Preimtime/Project_CRT/README.md

# Projektarbeit_CRT
Work by Alexander Preimesberger and Frank Ebel.
