Preimtime/Project_CRT/presentation/presentation.tex

%%%%%%%%%%%%%%%%%%%%%%%%%%%%%%%%%%%%%%%%%
% Beamer Presentation
% LaTeX Template
% Version 1.0 (10/11/12)
%
% This template has been downloaded from:
% http://www.LaTeXTemplates.com
%
% License:
% CC BY-NC-SA 3.0 (http://creativecommons.org/licenses/by-nc-sa/3.0/)
%
%%%%%%%%%%%%%%%%%%%%%%%%%%%%%%%%%%%%%%%%%

%----------------------------------------------------------------------------------------
%	PACKAGES AND THEMES
%----------------------------------------------------------------------------------------

\documentclass[aspectratio=169]{beamer}

\mode<presentation> {

% The Beamer class comes with a number of default slide themes
% which change the colors and layouts of slides. Below this is a list
% of all the themes, uncomment each in turn to see what they look like.

%\usetheme{default}
%\usetheme{AnnArbor}
%\usetheme{Antibes}
%\usetheme{Bergen}
%\usetheme{Berkeley}
%\usetheme{Berlin}
%\usetheme{Boadilla}
%\usetheme{CambridgeUS}
%\usetheme{Copenhagen}
%\usetheme{Darmstadt}
%\usetheme{Dresden}
%\usetheme{Frankfurt}
%\usetheme{Goettingen}
%\usetheme{Hannover}
%\usetheme{Ilmenau}
%\usetheme{JuanLesPins}
%\usetheme{Luebeck}
\usetheme{Madrid}
%\usetheme{Malmoe}
%\usetheme{Marburg}
%\usetheme{Montpellier}
%\usetheme{PaloAlto}
%\usetheme{Pittsburgh}
%\usetheme{Rochester}
%\usetheme{Singapore}
%\usetheme{Szeged}
%\usetheme{Warsaw}

% As well as themes, the Beamer class has a number of color themes
% for any slide theme. Uncomment each of these in turn to see how it
% changes the colors of your current slide theme.

%\usecolortheme{albatross}
%\usecolortheme{beaver}
%\usecolortheme{beetle}
%\usecolortheme{crane}
%\usecolortheme{dolphin}
%\usecolortheme{dove}
%\usecolortheme{fly}
%\usecolortheme{lily}
%\usecolortheme{orchid}
%\usecolortheme{rose}
%\usecolortheme{seagull}
%\usecolortheme{seahorse}
%\usecolortheme{whale}
%\usecolortheme{wolverine}

%\setbeamertemplate{footline} % To remove the footer line in all slides uncomment this line
%\setbeamertemplate{footline}[page number] % To replace the footer line in all slides with a simple slide count uncomment this line

%\setbeamertemplate{navigation symbols}{} % To remove the navigation symbols from the bottom of all slides uncomment this line
}

\usepackage{graphicx} % Allows including images
\usepackage{booktabs} % Allows the use of \toprule, \midrule and \bottomrule in tables

\usepackage{siunitx}
\usepackage{caption}
\usepackage{subcaption}

%----------------------------------------------------------------------------------------
%	TITLE PAGE
%----------------------------------------------------------------------------------------

\title[CRT]{Preliminary research on an electron beam setup for the QUAK experiment} % The short title appears at the bottom of every slide, the full title is only on the title page

\author{Frank Ebel\\ Alexander Preimesberger} % Your name
\institute[TU] % Your institution as it will appear on the bottom of every slide, may be shorthand to save space
{
TU Wien \\ % Your institution for the title page
\medskip
01429282\\ 01427641
}
\date{15. March 2021} % Date, can be changed to a custom date

\begin{document}

\begin{frame}
\titlepage % Print the title page as the first slide
\end{frame}

\begin{frame}
\frametitle{Overview} % Table of contents slide, comment this block out to remove it
\tableofcontents % Throughout your presentation, if you choose to use \section{} and \subsection{} commands, these will automatically be printed on this slide as an overview of your presentation
\end{frame}

%----------------------------------------------------------------------------------------
%	PRESENTATION SLIDES
%----------------------------------------------------------------------------------------

%------------------------------------------------
\section{CRT} % Sections can be created in order to organize your presentation into discrete blocks, all sections and subsections are automatically printed in the table of contents as an overview of the talk
%------------------------------------------------

\subsection{Characterization} % A subsection can be created just before a set of slides with a common theme to further break down your presentation into chunks

\begin{frame}
	\frametitle{Characterization}
	\begin{itemize}
		\item Model Heerlen D14-363GY/123
		\item Voltage \SI{2}{\kilo\volt}
		\item Filament heating voltage \SI{\approx 6}{\volt}
		\item Metal oxide cathode with barium-, strontium-, and possibly aluminum-oxide
	\end{itemize}
\end{frame}

%------------------------------------------------

\begin{frame}
	\frametitle{CRT}
	\begin{figure}
		\centering
		\begin{subfigure}{.4\textwidth}
			\centering
			
		\end{subfigure}%
		\begin{subfigure}{.4\textwidth}
			\centering
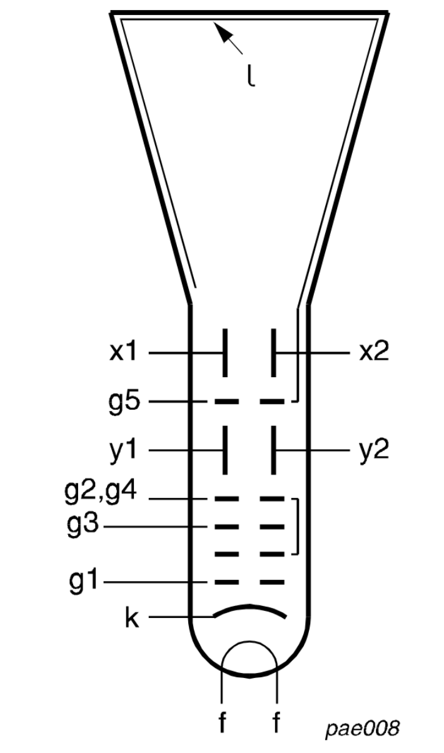
[picture p1: Chapters/CRT-Basics/electrode configuration.png]
			
		\end{subfigure}
	\end{figure}
\end{frame}

%------------------------------------------------

\begin{frame}
	\frametitle{Cathode SEM image}
	\begin{figure}
		\centering
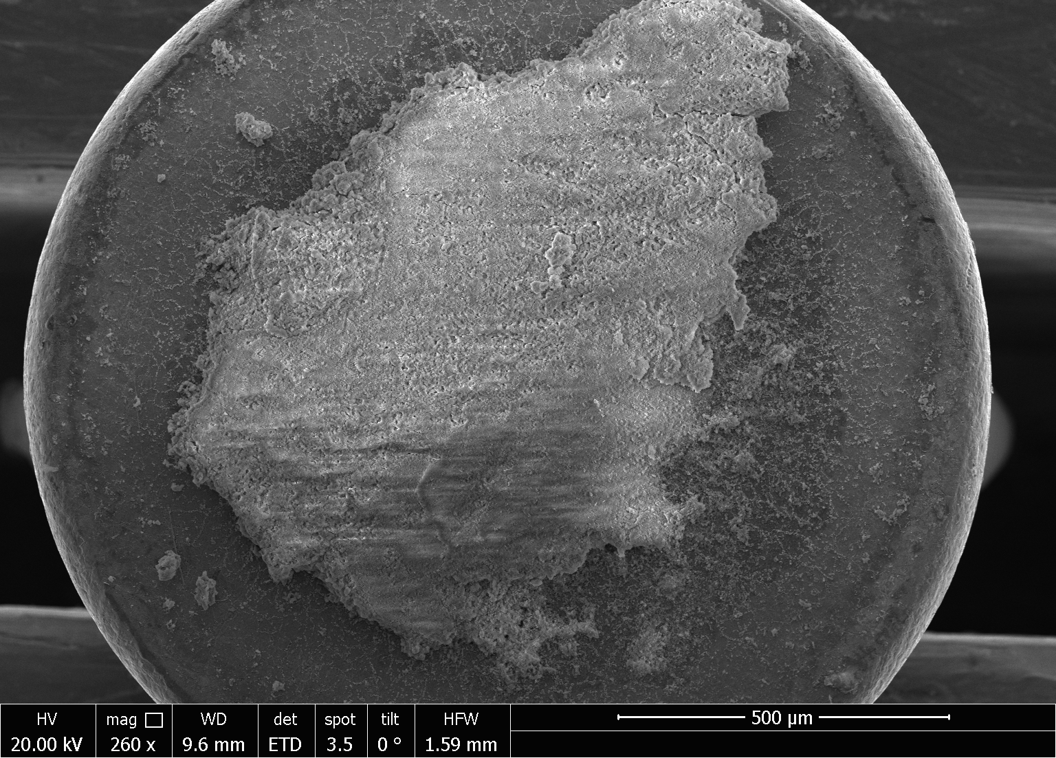
[picture p2: Chapters/CRT-Basics/SEM_image.png]
		
	\end{figure}
\end{frame}

%------------------------------------------------

\begin{frame}
	\frametitle{Heater}
	\begin{figure}[ht]
		\centering
		 \\
		\vspace{0.5cm}
		
	\end{figure}
\end{frame}

%------------------------------------------------
\subsection{Cutting}

\begin{frame}
	\frametitle{Wire cutting}
	\begin{figure}[ht]
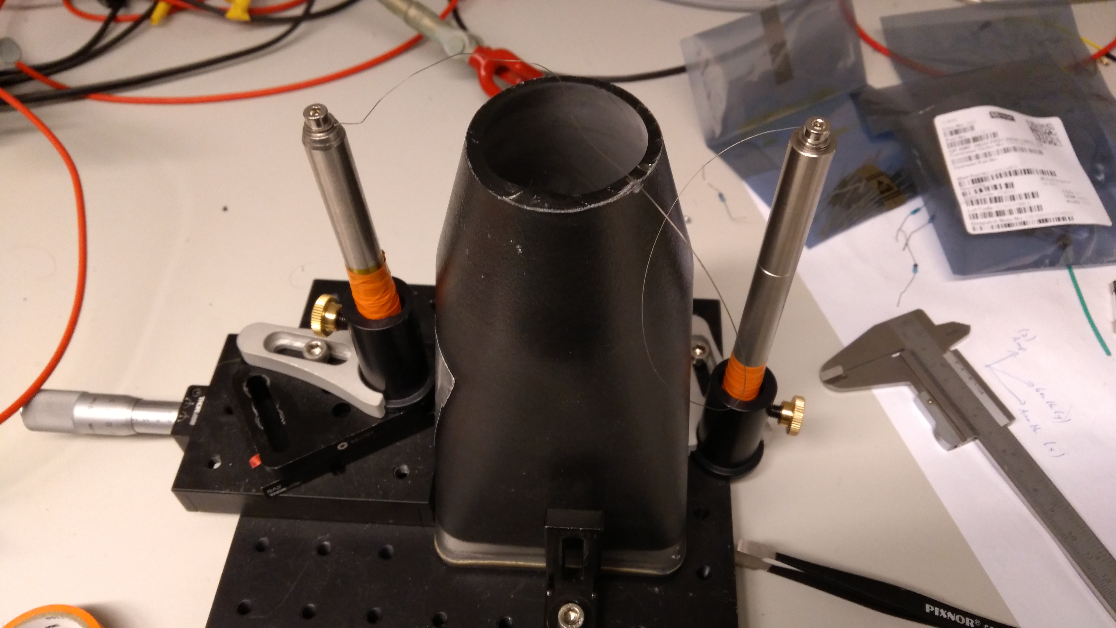
[picture p3: Chapters/CRT-handling/Cutting_Stage.jpg]
		
	\end{figure}
\end{frame}

%------------------------------------------------
\section{Vacuum test chamber}

\begin{frame}
	\frametitle{3D rendering}
	\begin{figure}[ht]
		\centering
		
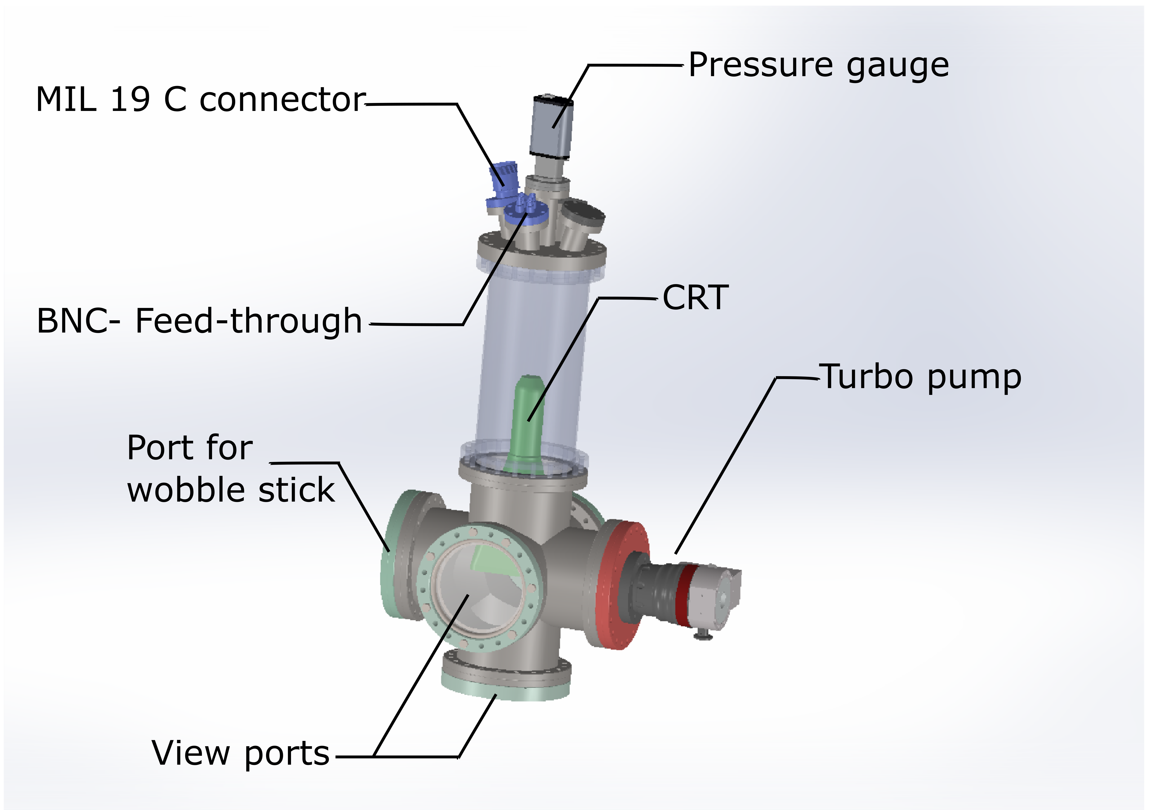
[picture p4: Chapters/vacuum-chamber/vacuum-chamber-annotated.png]
		 % taken from OneNote QuaK/Vacuum Setup/Test vacuum chamber
	\end{figure}
\end{frame}

%------------------------------------------------
\section{Deflection Electronics}

\begin{frame}
	\frametitle{Deflection Electronics}
	\begin{figure}[ht]
		\centering
		
	\end{figure}
\end{frame}

%------------------------------------------------

\begin{frame}
	\frametitle{Deflection circuit diagram}
	\begin{figure}[ht]
		\centering
		
	\end{figure}
\end{frame}

%------------------------------------------------

\begin{frame}
	\frametitle{Measurements of center tapped transformer}
	\begin{figure}[ht]
		\centering
		\begin{subfigure}{0.4\textwidth}
			\centering
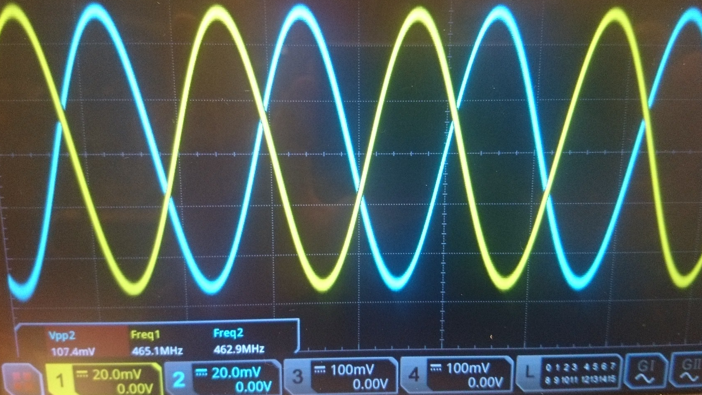
[picture p5: Chapters/Deflection/unbiased3.png]
			
			\caption{Unbiased at \SI{465}{\mega\hertz}}
		\end{subfigure}
		\hspace{0.1\textwidth}
		\begin{subfigure}{0.4\textwidth}
			\centering
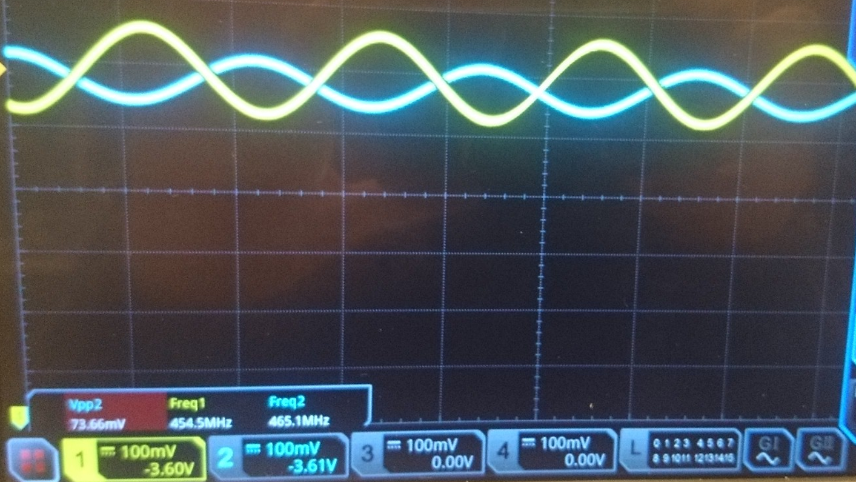
[picture p6: Chapters/Deflection/biased3.png]
			
			\caption{Biased at \SI{465}{\mega\hertz}}
		\end{subfigure}
	\end{figure}
\end{frame}

%------------------------------------------------
\section{Beam characterization}

\begin{frame}
	\frametitle{First measurements of e-beam}
	\begin{figure}[h]
		\centering
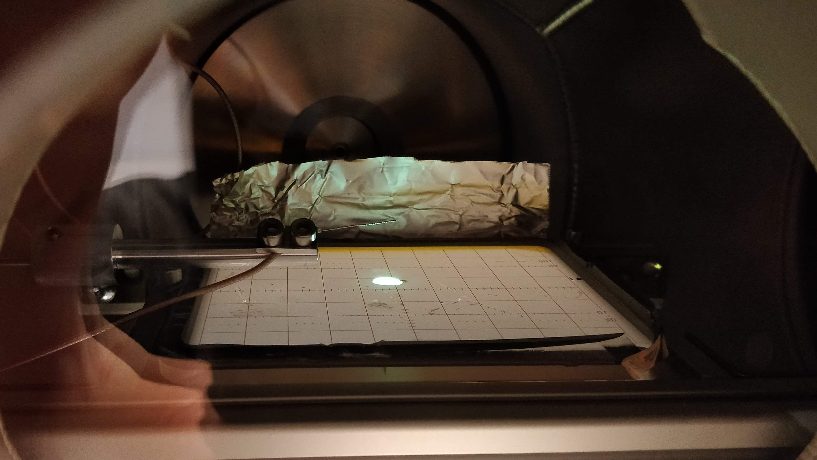
[picture p7: Chapters/beam-characterization/center_image.jpg]
		
	\end{figure}
\end{frame}

%------------------------------------------------

\begin{frame}
	\frametitle{Measured beam current (aluminum)}
	\begin{figure}[h]
		\centering
		
	\end{figure}
\end{frame}

%------------------------------------------------

\begin{frame}
	\frametitle{Schematics Faraday cup}
	\begin{figure}[h]
		\centering
		
	\end{figure}
\end{frame}

%------------------------------------------------

\begin{frame}
	\frametitle{Measured beam current (cup)}
	\begin{figure}[h]
		\centering
		
	\end{figure}
\end{frame}
%------------------------------------------------

\begin{frame}
	\frametitle{Measurement of deflection frequency}
	\begin{figure}
		\centering
		
	\end{figure}
\end{frame}

%------------------------------------------------

\begin{frame}
\Huge{\centerline{Thank you for your attention!}}
\end{frame}

%----------------------------------------------------------------------------------------

\end{document}
