Preimtime/Project_CRT/Preamble/titlepage_alternative.tex

% !TeX encoding = UTF-8
% !TeX spellcheck = en_US
% !TeX root = ../Thesis.tex
\renewcommand{\maketitle}{
	\begingroup % Create the command for including the title page in the document
		\thispagestyle{empty}
		\newgeometry{bottom=3cm, top=3cm, left=2.5cm+\bindingOffset, right=2.5cm}
		\begin{center}
			\begin{figure}[h]
				\centering
				
			\end{figure}

			\vspace{\stretch{0.1}}
			\begin{LARGE}	
				\par\noindent%
%				{\Large DIPLOMARBEIT}\\
				{\large Project Report}\\
				\vspace{\stretch{0.1}}
				\textbf{\huge \title} \\
				\ifBOOL@subtitle
					\subtitle
				\fi
			\end{LARGE}
			
			\vspace{\stretch{0.3}}
				performed at \institute \\
				\ifBOOL@instituteLogo
					\begin{figure}[h]
						\centering
						
					\end{figure}
				\fi
				at \university\\
				Faculty of Physics
				
				\vspace{\stretch{0.3}}
				under the supervision of\\
				\textbf{\large \supervisor} \\
				\ifBOOL@advisors
					and \\
					\textbf{\large \advisors} \\
				\fi

				\vspace{\stretch{0.1}}
				by \\
				\vspace{\stretch{0.1}}
				\textbf{\Large \author} \\
				\vspace{\stretch{0.05}}
				Matrikelnummer: \authorMatriculationNumber \\
				\vspace{\stretch{0.02}}
				\authorAdress
				\vspace{\stretch{0.1}}
		\end{center}
		
		\ifsigned
			\authorSign \\
			\vspace{\stretch{0.3}} \\
			\supervisorSign
		\fi
		
		\ifplace
			\placeSign
		\fi
		\restoregeometry
	\endgroup	
}
