Preimtime/Project_CRT/Chapters/CRT-handling/CRT-handling.tex

% !TeX encoding = UTF-8
% !TeX spellcheck = en_US
% !TeX root = ../../Thesis.tex

\chapter{CRT handling}
\label{chap:CRT handling}

\section{Opening CRTs}
\label{sec:Opening CRTs}

In order to have a free electron beam in the experimental setup to  manipulate the internal states of cold potassium atoms in a coherent way, it is necessary to open the CRT. This section explains the different methods which were tried and which resulted in clean and easy cuts. All slices were made in a glove box filled with nitrogen gas (\cref{fig:glovebox}) to reduce oxygen poisoning of the cathode.

\begin{figure}[ht]
	\centering
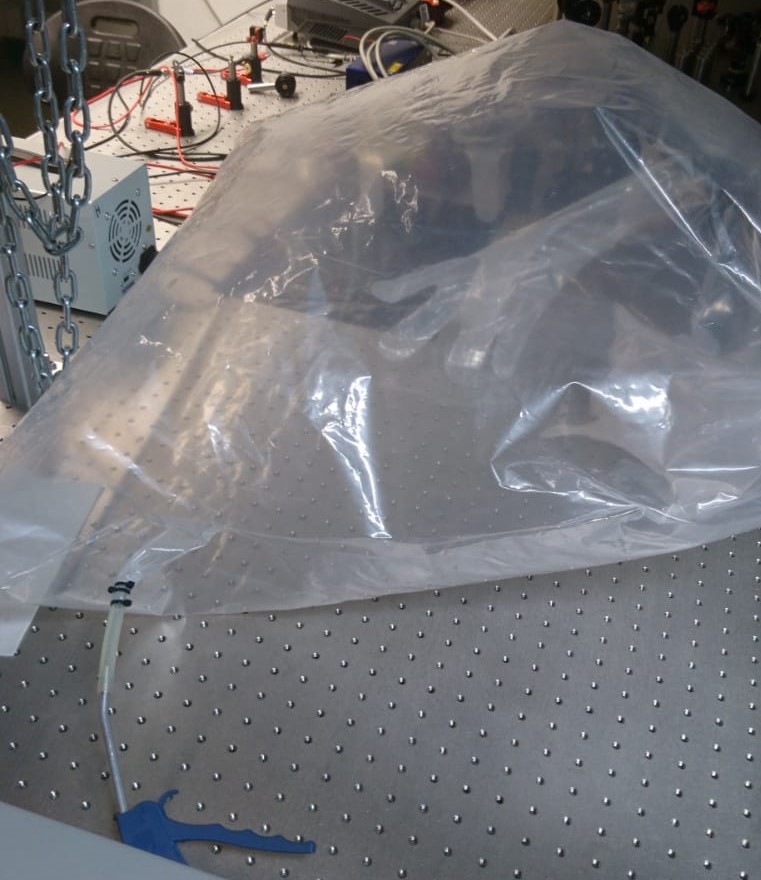
[picture p13: Chapters/CRT-handling/glove_box.jpg]
	
	\caption{Glovebox filled with nitrogen gas to open CRTs.}
	\label{fig:glovebox}
\end{figure}

\subsection{Rotary tool}
\label{subsec:Rotary tool}

First, a small hole was drilled in the center of the CRT pins to pressurize the CRT with nitrogen. Then a diamond wheel attached to a rotary tool was used to cut the glass. This method was tried twice, but did not work well. A lot of glass dust was produced, which adhered to the electron optics. Additionally, the dust got stuck to the inside of the plastic box and obscured the view of the blade while cutting.

\subsection{Wire cutting}
\label{subsec:Wire cutting}

Higher success was achieved by cutting the glass with a heated wire. A small hole was cut into the glove box in which two wires were put through. The hole was sealed with hot glue. A small height adjustable stage was built out of optic element mounts (\cref{fig:Stage to cut CRT with wire}) in which the CRT was put with the phosphor screen facing down. A steel wire (made from a mixture of Fe 70/Cr 25/Al 5) with a diameter of \SI{0.25}{\milli\meter} was looped around the CRT. It is important to keep a small gap in the loop to avoid an electrical short. Therefore two notches were made into the CRT glass in which the wire was fixed.

The assembly was put inside the glove box, which was subsequently filled with nitrogen. A current of approximately \SIrange{2}{2.5}{\ampere} was used to heat the thin wire which resulted in a clean fracture inside the CRT glass. This method does not require a CRT pressurization before the cut and was first extensively tested on empty drinking glasses.

\begin{figure}[ht]

	
	%\missingfigure[figwidth=0.9\textwidth]{Image of Stage.}
	\caption{Stage to cut CRT with wire.}
	\label{fig:Stage to cut CRT with wire}
\end{figure}

\section{Oxygen poisoning}
\label{sec:Oxygen poisoning}

As mentioned in \cref{ch:Cathodic Ray Tube Basics} it is paramount to avoid contact of the cathode with oxygen. Therefore tests with a broken CRT were made to test on how well it can be isolated from air.

% daily notes 2019-12-11
The first experiment consisted of filling a drinking glass put upside-down with helium. After a set amount of time a a burning lighter was put inside. If the fire went off, it meat that oxygen did not get inside. This was tested successfully with a waiting time of \SIrange{0.5}{10}{\minute}.

Next, plastic wrap was put on top of the glass filled with nitrogen by a rubber band. The glass was put with the open side up from \SIrange{3}{10}{\minute} after which it was turned upside down and the foil was removed. A lighter was put inside and the flame went out again.

To improve the precision, a He leak tester was used. For the first two tests, one plastic foil and one rubber band were used; for the third test three foils and two rubber bands; and for the last test an aluminum foil was hot glued on the CRT to seal it. The measurement locations are shown in \cref{fig:Measurement locatiosn of He leakage}. For the glued seal, leakage was measured on the whole circumference. In \cref{tab:He leak test series.} `glue avg' denotes the average leak rate of this measurement while `glue max' describes the highest value. A seal with rubber band and clear foil tend to higher leakage. Based on these measurements it is recommended to use glued aluminum. But care needs to be taken in order ensure that the whole CRT is sealed since even a small leak can result in a rate around an order of magnitude above the background.

\begin{table}[ht]
	\centering
	\caption{He leak test.}
	\label{tab:He leak test series.}
	
	\begin{tabular}{l S}
		\toprule
		
		location & {leak rate/(\SI{e-5}{\milli\bar.\litre/\second})} \\
		\midrule
		
		% 1st video
		\multicolumn{2}{c}{1 plastic foil, 1 rubber band} \\
		background & 8 \\
		plastic foil & 20 \\
		He gas cylinder & 200 \\
		\midrule
		
		% 2nd video
		\multicolumn{2}{c}{1 plastic foil, 1 rubber band} \\
		background & 7 \\
		plastic foil & 20 \\
		rubber band & 40 \\
		\midrule
		
		% 3rd video
		\multicolumn{2}{c}{3 foils, 2 rubber bands} \\
		background & 20 \\
		plastic foil & 30 \\
		rubber band & 70 \\
		\midrule
		
		% 4th video
		\multicolumn{2}{c}{1 aluminum foil, hot glue} \\
		background & 6 \\
		glue avg & 7 \\
		glue max & 60 \\
		aluminum foil & 8 \\
		\bottomrule
	\end{tabular}
\end{table}

\begin{figure}[ht]
	\centering
	
	\begin{subfigure}[b]{0.4\textwidth}
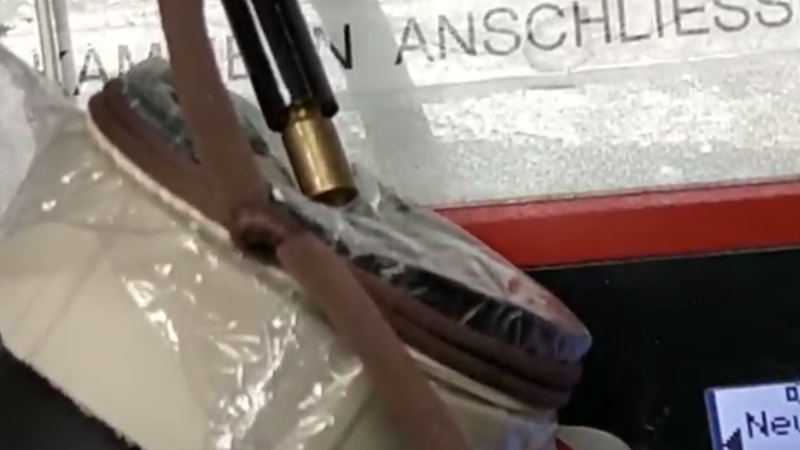
[picture p14: Chapters/CRT-handling/plastic_foil.png]
		
		\caption{plastic foil}
	\end{subfigure}
	\hspace{0.1\textwidth}
	\begin{subfigure}[b]{0.4\textwidth}
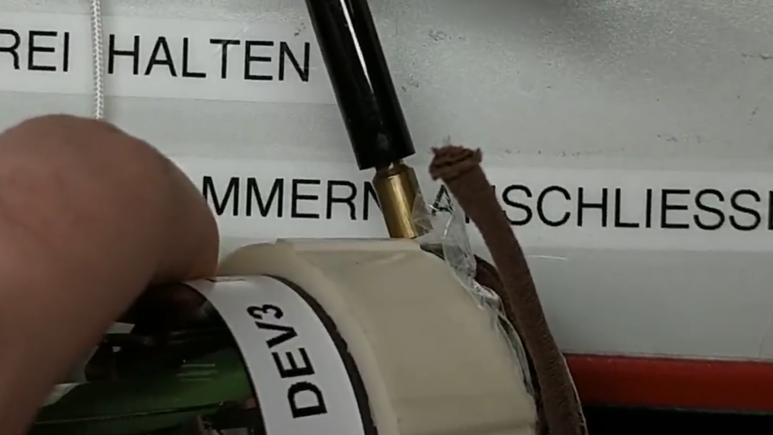
[picture p15: Chapters/CRT-handling/rubber_band.png]
		
		\caption{rubber band}
	\end{subfigure}

	\vspace{1cm}
	
	\begin{subfigure}[b]{0.4\textwidth}
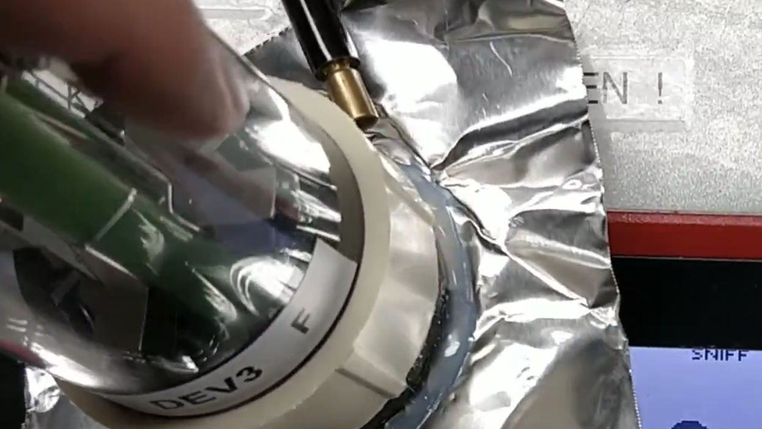
[picture p16: Chapters/CRT-handling/glue.png]
		
		\caption{glue}
	\end{subfigure}
	\hspace{0.1\textwidth}
	\begin{subfigure}[b]{0.4\textwidth}
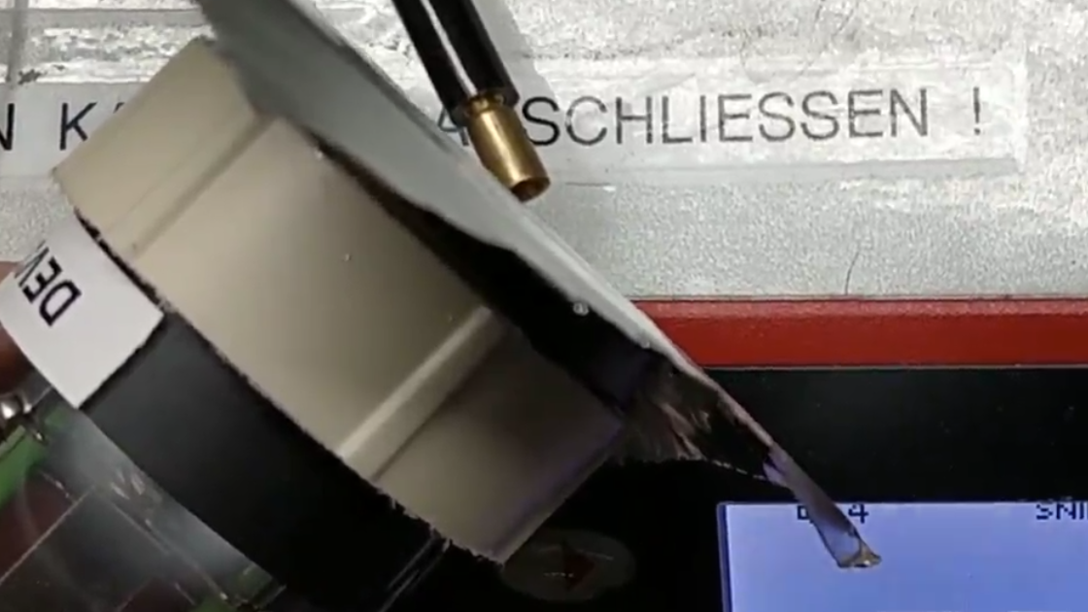
[picture p17: Chapters/CRT-handling/aluminum_foil.png]
		
		\caption{aluminum}
	\end{subfigure}
	
	\caption{Measurement locations of He leakage.}
	\label{fig:Measurement locatiosn of He leakage}
\end{figure}
