Preimtime/Project_CRT/Chapters/Deflection/Deflection.tex

% !TeX encoding = UTF-8
% !TeX spellcheck = en_US
% !TeX root = ../../Thesis.tex

\chapter{Deflection Electronics}

\section{Demands on the setup}

For the QUAK experiment it is paramount to be able to deflect a beam of a sufficient current precisely at the right frequency with a sufficiently small bandwidth. 
As previously mentioned, our deflection system simply consists of two pairs of parallel plates between which an alternating voltage is applied. Controlling this voltage allows us to control the deflection of the beam. Various aspects are important here (illustrated in \cref{fig:VoltageAspects}):

\begin{description}
	
	\item[Offset:] Although the deflection of the beam is controlled by the voltage between the plates, it is necessary to be able to set their mean potential as well. During normal operation this offset voltage is at \SI{96}{\volt} for the x-direction and at \SI{78}{\volt} for the y-direction. These offsets are necessary to keep the beam focused.
	\item[Amplitude:] The deflection coefficients in the x and y planes are \SI{19}{\volt\per\centi\meter} and \SI{11.5}{\volt\per\centi\meter} respectively (see \cite{D14363GY123-manual}). We therefore need to be able to supply up to \SI{100}{\volt} in order to be able to move the beam in a large enough area.
	\item[Frequency:] The final goal is to be able to deflect the electron beam at the hyperfine splitting frequency of $^{39}\mathrm{K}$, which is \SI{461.7}{\mega\hertz} or $^{41}\mathrm{K}$, with a frequency of \SI{254}{\mega\hertz}. This is likely to prove impossible with this CRT-model, observations at the highest frequency we have tried so far will be discussed in section \cref{sec:Deflection frequency}.
	\item[Waveform:] Ultimately we want the cold atoms to experience a field that oscillates like a sine wave. As a first try it is therefore reasonable to apply a sinusoidal voltage.
	\item[Lissajous curves:] Having the ability to control the deflection in both the x- and the y- axis, allows us to have our beam draw out Lissajous Curves (\cref{fig:Lissajous Curves}). By applying sine waves of equal frequency to both pairs of deflection plates and by being able to control the phase between them we can have the beam oscillate on a straight line or a circle. This allows us to generate either a linearly or circularly polarized field.
\end{description}

\begin{figure}[ht]
	\centering
		
	\caption{Charactaristics of the generated deflection voltages.}
	\label{fig:VoltageAspects}
\end{figure}

\begin{figure}[ht]
	\centering
	
	\begin{tikzpicture}
		\input{./Chapters/Deflection/fig_Lissajous}
	\end{tikzpicture}
	
	\caption{Lissajous Curves.}
	\label{fig:Lissajous Curves}
\end{figure}

\section{Implementation}

\begin{figure}[ht]
	\centering
	
	\begin{tikzpicture}
		\input{./Chapters/Deflection/fig_deflection_electonics}
	\end{tikzpicture}
	\caption{Deflection circuit.}
	\label{fig:deflec_circuit}
\end{figure}

\begin{figure}[ht]
	\centering
	\begin{subfigure}{0.4\textwidth}
		\centering
		
		\caption{}
		%\label{fig:circuit_phase}
	\end{subfigure}
	\hspace{0.1\textwidth}
	\begin{subfigure}{0.4\textwidth}
		\centering
		
		\caption{}
		%\label{fig:PCB_phase}
	\end{subfigure}
	\caption{Images of deflection plates.}
	\label{fig:deflection plates}
\end{figure}

A first setup with which we can try to obtain the desired voltages is depicted in \cref{fig:deflec_circuit}. On the  very left we have a signal generator that is capable of producing the right frequency (\SI{461.7}{\mega\hertz}) this signal is then split up into an x-, and a y-branch. One of the two branches is connected to a phase shifter, which is able to delay the input signal by up to \SI{200}{\degree}, allowing us to set any desired phase shift between x-, and y-deflection and to correct for inadvertent delays from the other electronics. Both the x-, and  y-signal are then amplified using Mini Circuits ZHL amplifiers. In the final step, a center tapped transformer allows us to produce voltages for the plates X1 and X2 (or Y1 and Y2 respectively) with a phase shift of exactly \SI{180}{\degree} between them. By setting the center tap to the desired offset potential, we should get the voltage curves described above. To understand this setup in more detail, it is useful to examine its most important parts more closely:

\begin{description}
	\item[Amplifier:] Up to now we have used the Mini Circuits ZHL 32A \cite{MiniCircuits2021a}  and the ZHL 1A \cite{MiniCircuits2021} amplifier, which have a fixed gain of \SIlist{25; 16}{\decibel} respectively. Inputs and outputs can simply be connected via BNC cables. The amplifier is powered by a linear power supply with a DC voltage of \SI{24}{\volt} via two banana plugs in the front. Since we want to control the Lissajous curves shapes (as the deflection coefficients for the x- and y- plates differ), it is desirable to be able to adjust the amplifier gain in future versions of the setup. 
	
	\item[Center Tapped Transformer:] The center tapped transformer we use is the Mini-Circuits TC8-1G2+ (\cite{TC8-1G2}), a transformer for frequencies between \SIrange{2}{500}{\mega\hertz}, with an impedance ratio of 8. \Cref{fig:CTT} shows how the center tapped transformer is implemented. The in- and outputs, as well as the bias voltage can be connected via BNC cables. As usual, the shields of all these cables are connected to ground, furthermore they are connected to each other and to the housing. As a safety feature, both outputs X1 and X2 are directly connected to the bias through an arrangement of diodes: Two connections, each with a normal diode and a Zener diode facing in opposite directions. The breakthrough voltage of the Zener diode is \SI{200}{\volt}, during normal operation the voltage on it stays below this value and none of the connections let any current through as one of the two diodes is always blocking it. However if one of the plates in the CRT accidentally comes in contact with high voltage, the connection with the appropriately oriented Zener diode opens up, preventing a voltage spike on the center tapped transformer and thereby protecting the electronics connected to its primary circuit.
	At the point of writing there are still some problems with the behavior of the center tapped transformer, the capacitance of the diodes introduces an undesired phase shift between the two signals. \Cref{fig:unbiased2} shows the circuit's behavior at \SI{465}{\mega\hertz} without its diodes, here the signals are shifted by $\SI{120}{\pico\second} \mathrel{\widehat{=}} \SI{20}{\degree} = \SI{0.35}{\radian}$. Additionally, applying a bias voltage leads to differing amplitudes, as can be seen in \cref{fig:biased2}.
	
	\item[Phase Shifter:] To control the phase shift between the x- and y-deflection plates, we use a Mini-Circuits \cite{JSPHS-661} phase shifter. This part was put in a  housing (\cite{Hammond1455D601RD}) on a separate PCB and can be connected via BNC cables. \Cref{fig:circuit_phase} shows how the phase shifter is connected and \cref{fig:PCB_phase} shows the corresponding PCB layout. Note that again the shields of the BNC cables are connected among each other and to the housing. The JSPHS-661+ is designed for frequencies in the range \SIrange{400}{600}{\mega\hertz}. By applying a DC voltage of \SIrange{0}{12}{\volt} to the bias connector, it is possible to introduce a phase shift of up to \SI{200}{\degree} to the signal.
	
\end{description}

\begin{figure}[ht]
	\centering
	\begin{subfigure}{0.4\textwidth}
		\centering
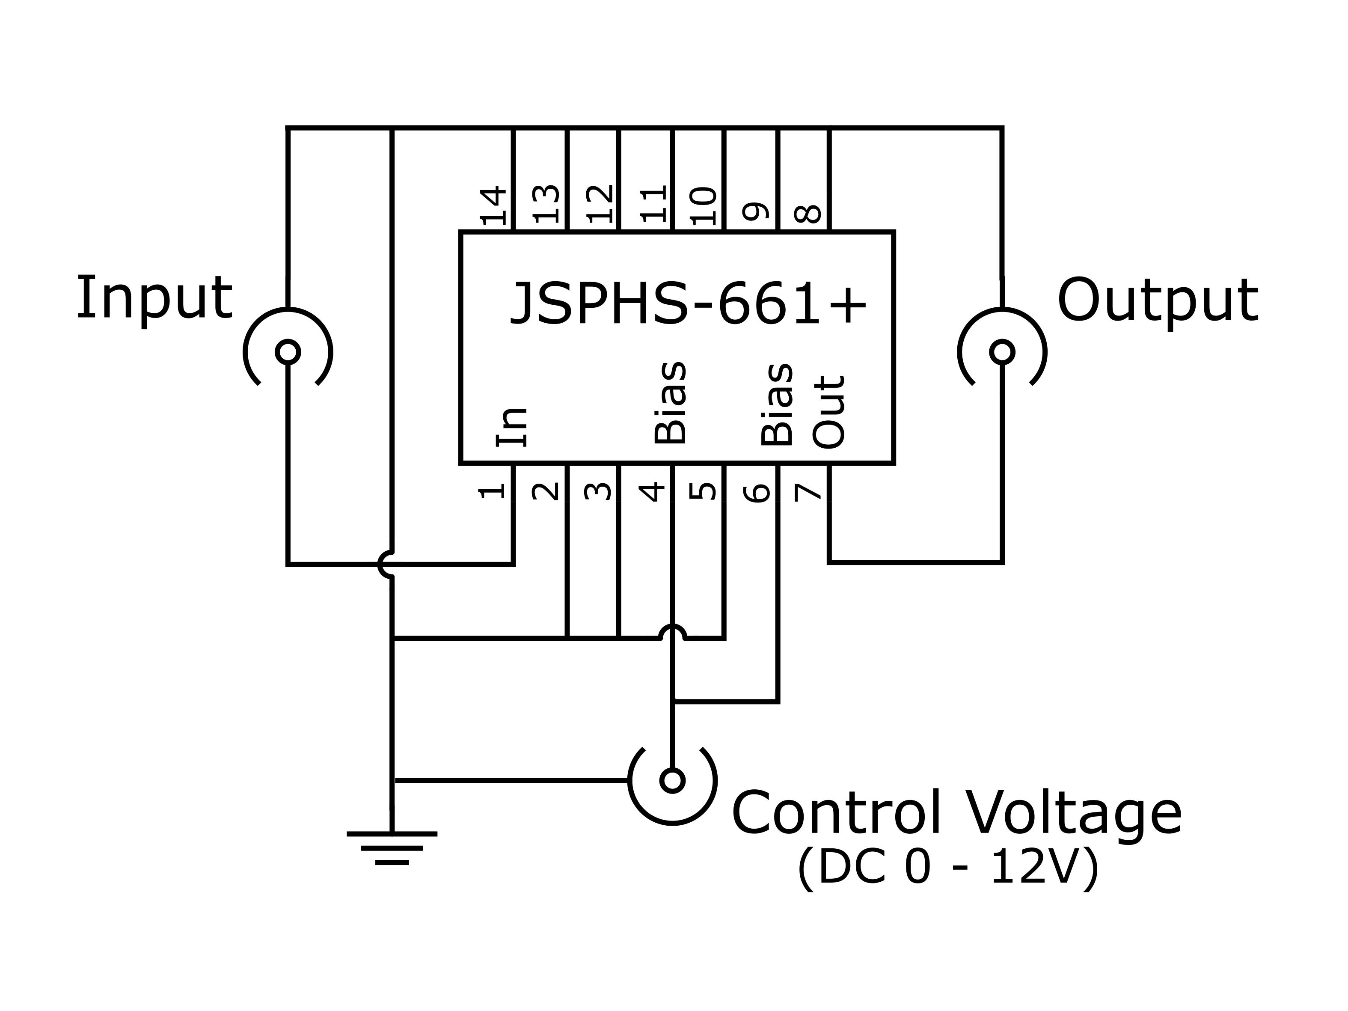
[picture p18: Chapters/Deflection/circuit_phase4zu3.png]
		
		\caption{Schematic of phase shifter connections.}
		\label{fig:circuit_phase}
	\end{subfigure}
	\hspace{0.1\textwidth}
	\begin{subfigure}{0.4\textwidth}
		\centering
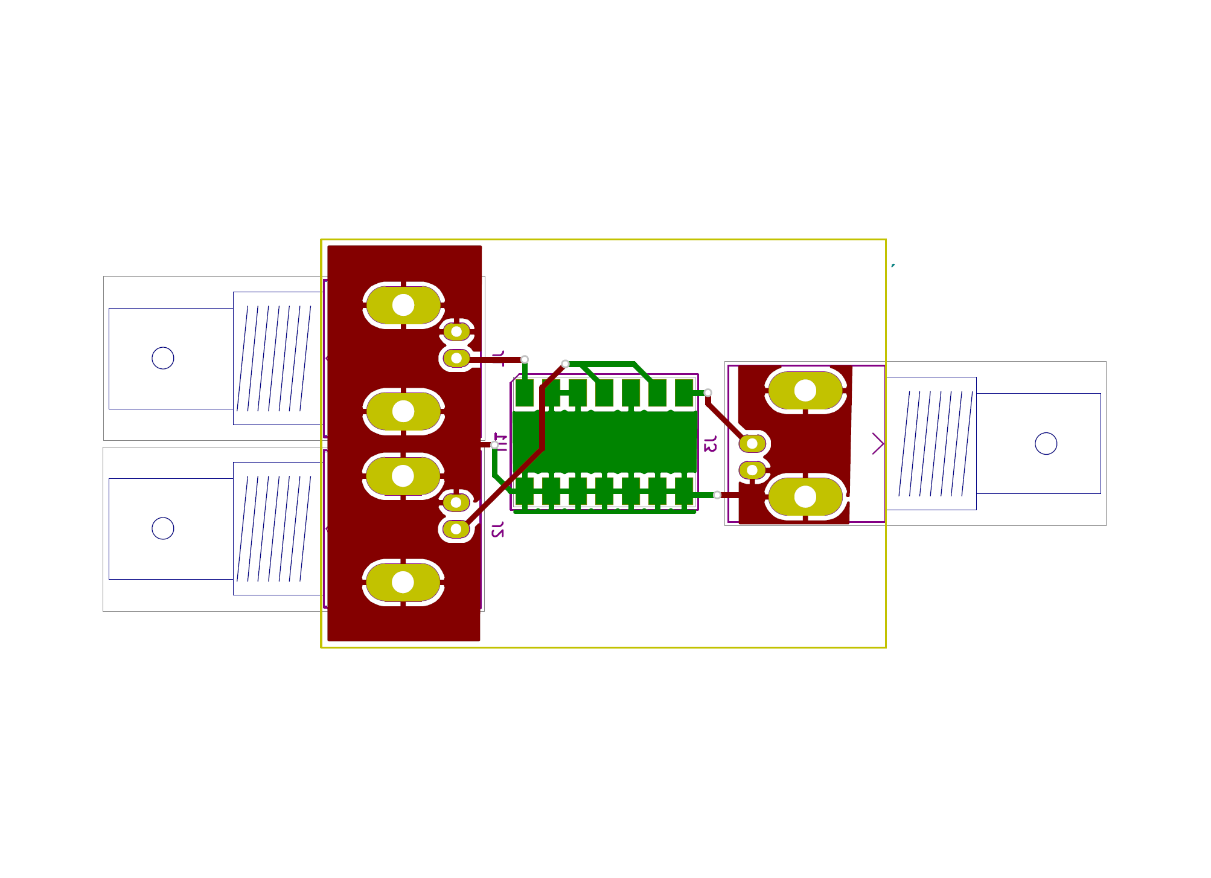
[picture p19: Chapters/Deflection/PCB_phase3.png]
		
		\caption{PCB-Layout of the phase shifter.}
		\label{fig:PCB_phase}
	\end{subfigure}
	\caption{}
	\label{fig:PhaseShifter}
\end{figure}

\begin{figure}[ht]
	\centering
	\begin{subfigure}{0.4\textwidth}
		\centering
		
		\caption{Signal of center tapped transformer without diodes, unbiased at \SI{465}{\mega\hertz}.(\SI{1}{\nano\second}/division horizontally and \SI{20}{\milli\volt}/division vertically) }
		\label{fig:unbiased2}
	\end{subfigure}
	\hspace{0.1\textwidth}
	\begin{subfigure}{0.4\textwidth}
		\centering
		
		\caption{Signal of center tapped transformer without diodes, biased at \SI{465}{\mega\hertz}.(\SI{1}{\nano\second}/division horizontally, \SI{100}{\milli\volt}/division vertically, \SI{-3.6}{\volt} offset)}
		\label{fig:biased2}
	\end{subfigure}
	\caption{}
	\label{fig:CTTSignal}
\end{figure}

\begin{figure}[ht]
	\centering
	\begin{subfigure}{0.4\textwidth}
		\centering
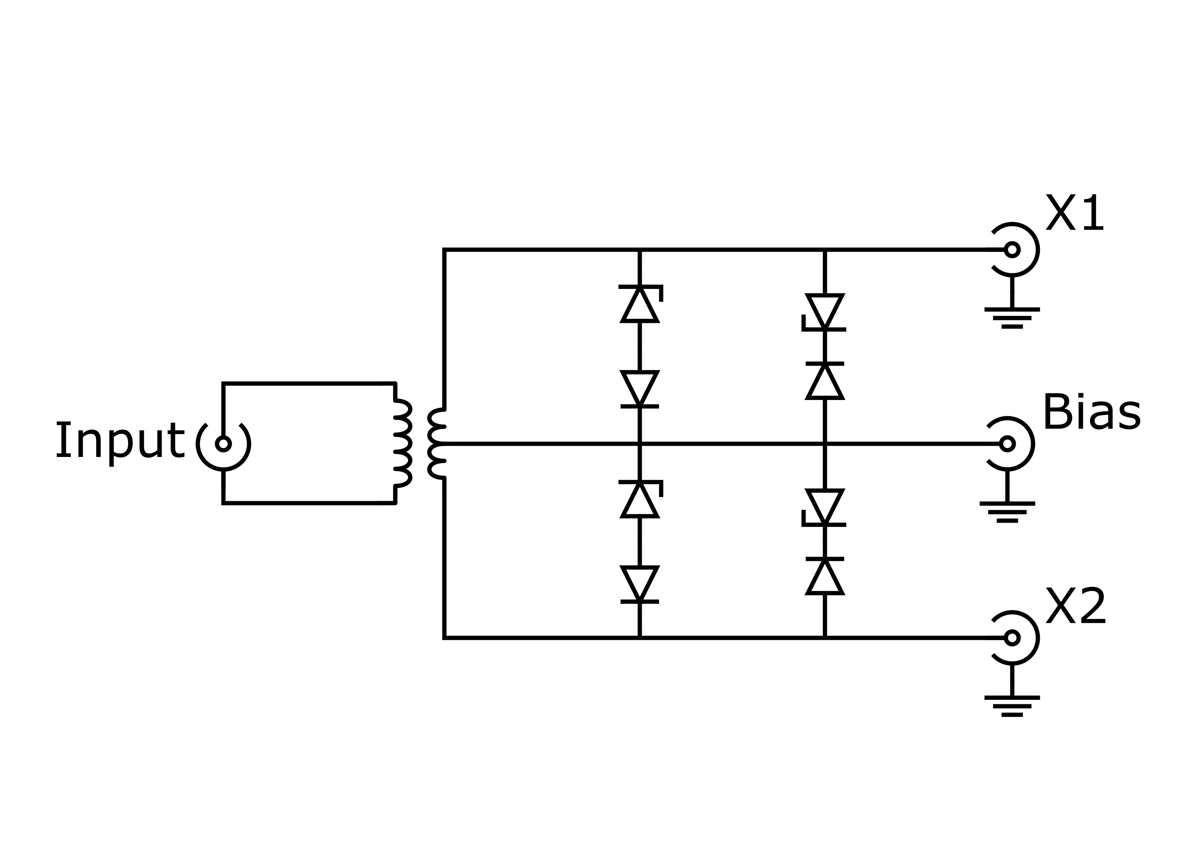
[picture p20: Chapters/Deflection/circuit_CTT4zu3.png]
		
		\caption{Schematic of center tapped transformer connections.}
		\label{fig:circuit_ctt}
	\end{subfigure}
	\hspace{0.1\textwidth}
	\begin{subfigure}{0.4\textwidth}
		\centering
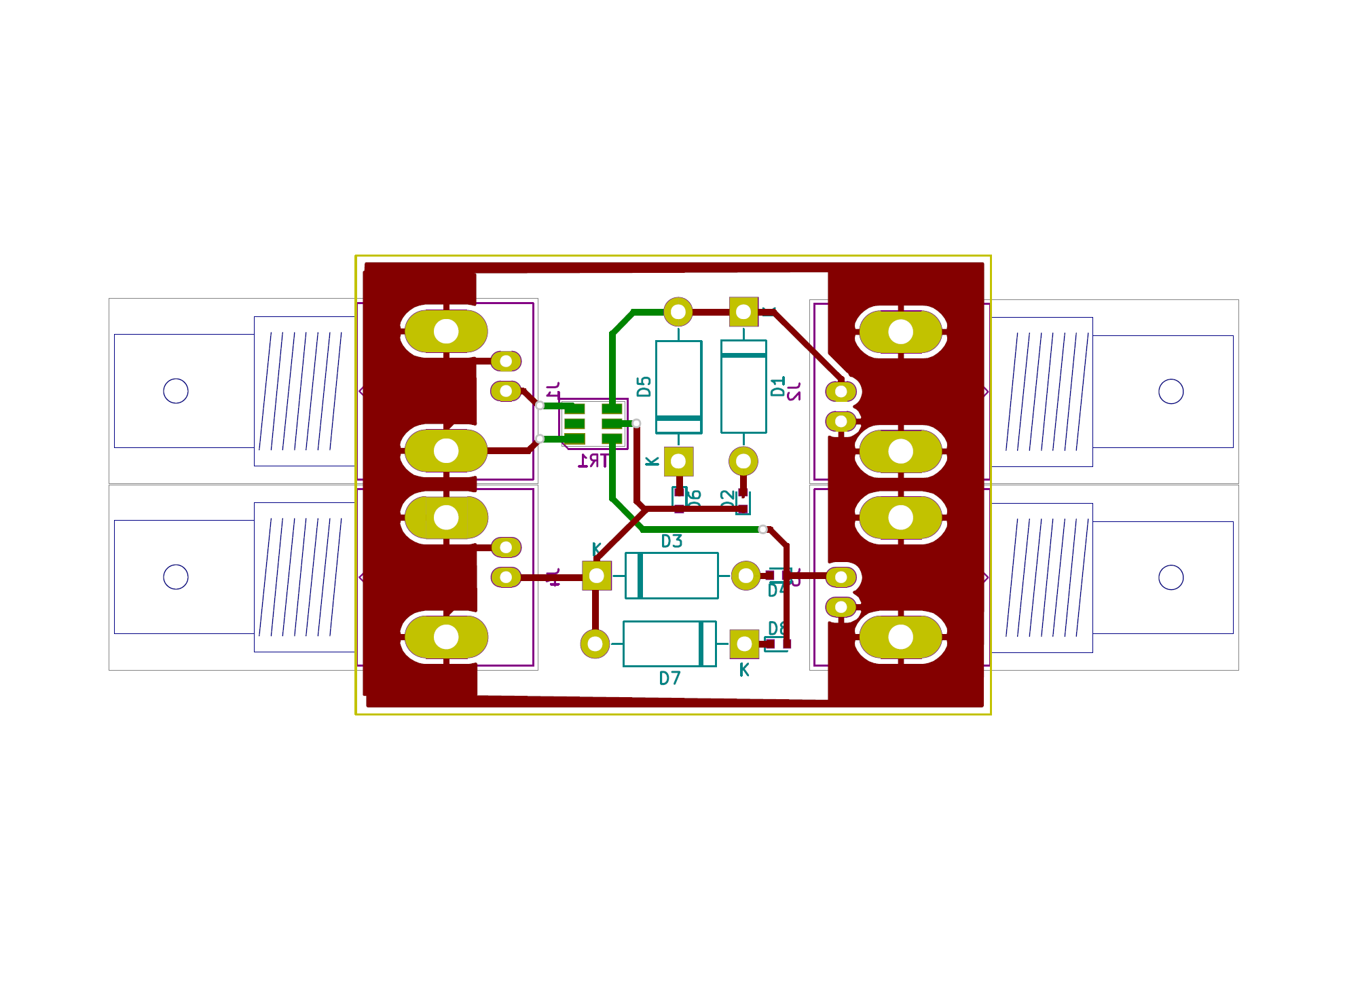
[picture p21: Chapters/Deflection/PCB_CTT3.png]
		
		\caption{PCB-Layout for center tapped transformer.}
		\label{fig:PCB_CTT}
	\end{subfigure}
	\caption{}
	\label{fig:CTT}
\end{figure}

\begin{figure}[ht]
	\centering
	\begin{subfigure}{0.4\textwidth}
		\centering
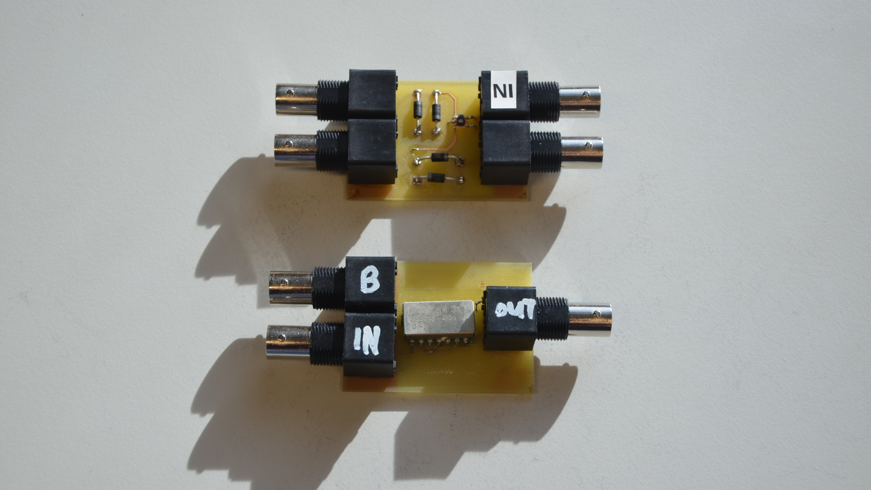
[picture p22: Chapters/Deflection/PS_CTT_16zu9.JPG]
		
		\caption{Finished PCBs.}
		\label{fig:ctt_ps}
	\end{subfigure}
	\hspace{0.1\textwidth}
	\begin{subfigure}{0.4\textwidth}
		\centering
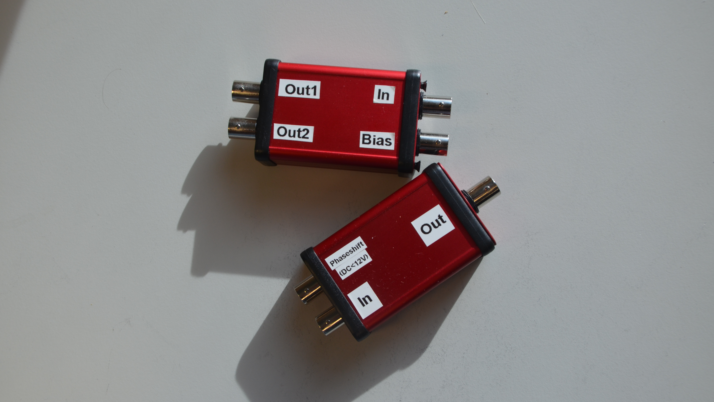
[picture p23: Chapters/Deflection/PS_CTT1_16zu9.JPG]
		
		\caption{Finished PCB in housing.}
		\label{fig:ctt_ps_housed}
	\end{subfigure}
	\caption{}
	\label{fig:CTT_housed}
\end{figure}
