Preimtime/Project_CRT/Chapters/Chapter3/chapter_3.tex

% !TeX encoding = UTF-8
% !TeX spellcheck = en_US
% !TeX root = ../../Thesis.tex
\chapter{Chapter 3}\label{chap:chapter_3}
This chapter contains a few Tikz sketches and diagrams as a inspiration and guide line to create your own Tikz figures.

\begin{figure}[H]
	\centering
	\resizebox{\textwidth}{!}{
		\begin{tikzpicture}[use optics, scale=1.0]
			\input{./Chapters/Chapter3/fig_DFS_scheme}
		\end{tikzpicture}
	}
	\caption[DFS setup]{optical setup for a \person{Doppler} free spectroscopy}
	\label{fig:dfs}
\end{figure}

\begin{figure}[H]
	\centering
	\begin{tikzpicture}[use optics, scale=0.7]
		\input{./Chapters/Chapter3/fig_reflective_imaging_sketch}
	\end{tikzpicture}
	\caption[optics sketch 1]{optics sketch 1}
	\label{fig:reflective_imaging_setup}
\end{figure}

\begin{figure}[H]
	\centering
	\begin{tikzpicture}[use optics, scale=0.7]
		\input{./Chapters/Chapter3/fig_trapping_with_wires}
	\end{tikzpicture}
	\caption[trapping atoms wiht a wire]{Trapping atoms with wires.}
	\label{fig:trapping_atoms_with_a_wire}
\end{figure}

%\clearpage
\begin{figure}[H]
	\centering	
	\begin{tikzpicture}[scale=0.55]
		\input{./Chapters/Chapter3/fig_Rb_hyperfine_structure}
	\end{tikzpicture}
	\caption[\Rb D1,D2 line]{\Rb hyperfine structure of the D1 and D2 line}
	\label{fig:Rb_hyperfine_structure}
\end{figure}

\begin{figure}[H]
	\centering
	\begin{tikzpicture}[scale=0.48]
		\input{./Chapters/Chapter3/fig_cryostat_overview}
	\end{tikzpicture}
	\caption[overview of cryogenic setup]{Overview sketch of the cryogenic setup}
	\label{fig:cryogenic_overview}
\end{figure}

\begin{figure}[H]
	\noindent
	\centering
	\begin{subfigure}[t]{0.49\textwidth}
		\centering
		\begin{tikzpicture}[use optics, scale=1.0]
		\input{./Chapters/Chapter3/fig_ECDL}
		\end{tikzpicture}
		\subcaption{}
		\label{fig:laser_types_ecdl}
	\end{subfigure}
	\begin{subfigure}[t]{0.49\textwidth}
		\centering
		\begin{tikzpicture}[use optics, scale=0.7]
		\input{./Chapters/Chapter3/fig_DFB_laser}
		\end{tikzpicture}
		\subcaption{}
		\label{fig:laser_types_dfb}
	\end{subfigure}
	\caption[laser types]{semiconductor laser types: (\subref{fig:laser_types_ecdl}) ECDL; (\subref{fig:laser_types_dfb}) DFB.}
	\label{fig:laser_types}
\end{figure}
