Preimtime/Project_CRT/Thesis.pdf

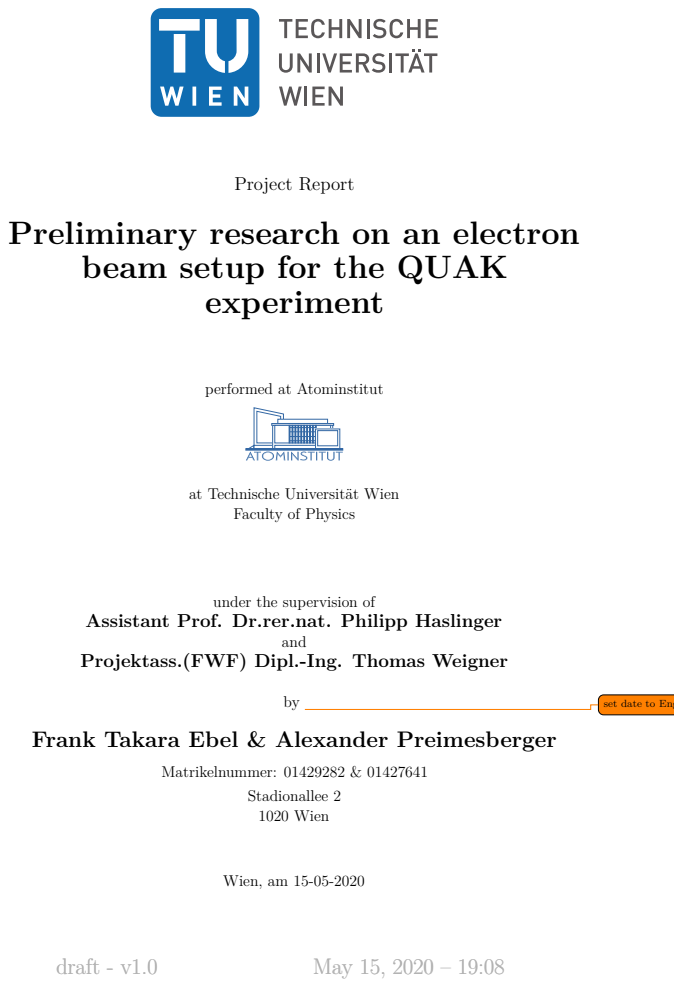
[picture p24: page 1]
draft - v1.0; May 15, 2020 – 19:08; Project Report; experiment; and; set date to English; Matrikelnummer: 01429282 & 01427641; Stadionallee 2 1020 Wien; Wien, am 15-05-2020

Preliminary research on an electron
beam setup for the QUAK

performed at Atominstitut

at Technische Universität Wien

Faculty of Physics

under the supervision of

Assistant Prof. Dr.rer.nat. Philipp Haslinger

Projektass.(FWF) Dipl.-Ing. Thomas Weigner

Frank Takara Ebel & Alexander Preimesberger

# Contents

1 Cathodic Ray Tube Basics | 1
Todo list | 9

i

# 1 Cathodic Ray Tube Basics

This section features a quick explanation what a CRT is and what its main components are, followed by a more detailed description on how these components are implemented in the CRT Heerlen D14-363GY, which was used in this project. It ends with a description of the important characteristics of the CRT and the requirement the theory poses on them.

## 1.1 Underlying Physics

Wikipedia states: “The cathode-ray tube (CRT) is a vacuum tube that contains one or more electron guns and a phosphorescent screen and is used to display images. It modulates, accelerates, and deflects electron beam(s) onto the screen to create the images.”

There are three vital components to accomplish this feat: the electron gun, the electron lens and the deflection plates.

The electron gun extracts electrons from a cathode material, accelerates them onto
a perforated anode and thereby produces a free electron beam (see fig. 1.1). One important characteristic in the selection of a cathode material is a low work function. 16 It denotes the amount of energy needed to extract one electron from the material. 17 There are two ways to overcome this energy barrier in an electron gun; one can either overcompensate it by applying a strong electric field (“field emission”, “cold cathode”, 19 fig. 1.2b); or one can heat the material until some electrons have enough thermal energy to overcome the energy barrier (“thermal emission”, “hot cathode”, fig. 1.2a). For our CRT, only thermal emission is relevant, more detail on this will be added later along with the description of our cathode’s design.

The cathode itself is housed in a so-called Wehnelt cylinder, as the name suggests it is conducting cylinder which is set to a slightly more negative potential than the cathode itself. This part implements two features; firstly it condenses the emitted electrons, leading to a smaller spot size, i.e. making the cathode a more point-like electron source. Secondly it enables us to regulate the beam current, the more negative the Wehnelt potential is, the less electrons are emitted by the electron gun. As we

1

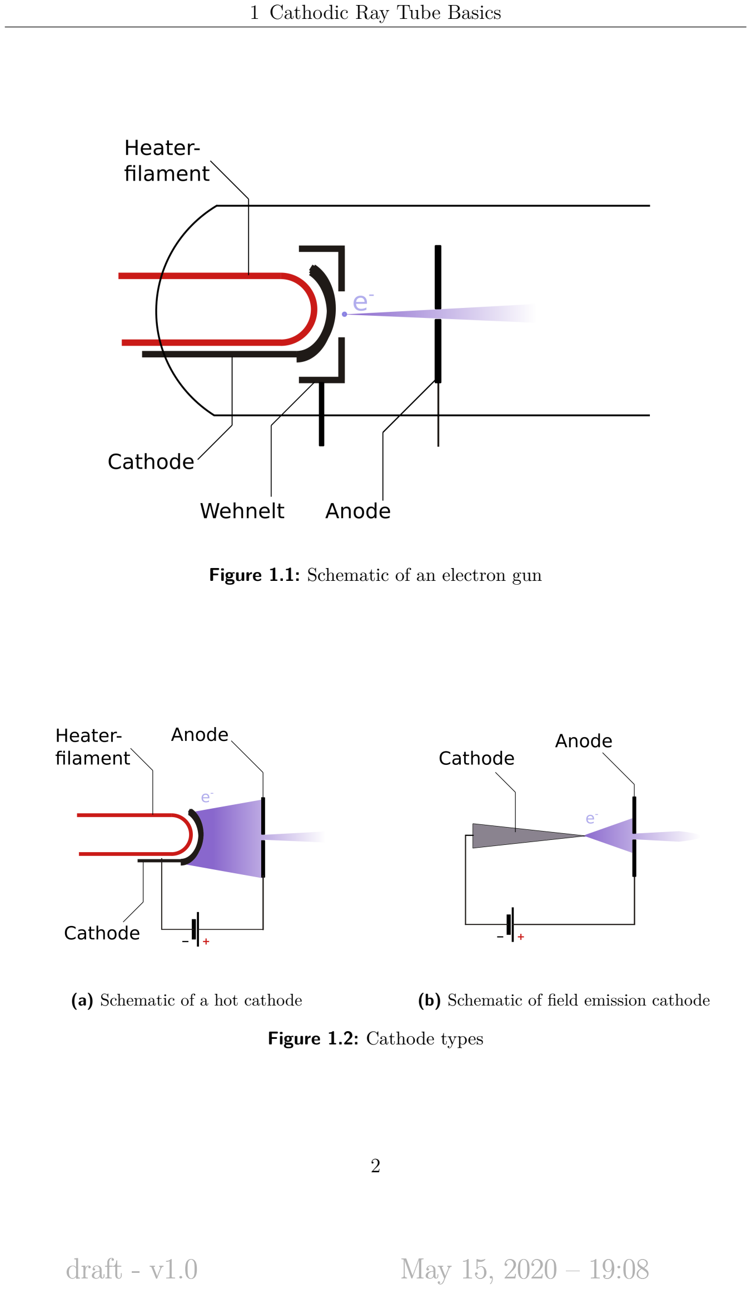
[picture p25: page 4]

1 Cathodic Ray Tube Basics

Figure 1.1: Schematic of an electron gun

(a) Schematic of a hot cathode | (b) Schematic of field emission cathode

Figure 1.2: Cathode types

2

1 Cathodic Ray Tube Basics

make the Wehnelt potential more positive, the beam current increases and continues | 1
to rise even after it is more positive than the cathode itself. However the spot size | 2
reduction is lost in the process, along with the ability to properly focus the beam with | 3
electron optics. | 4
The electrons that leave the electron gun are still divergent and need to be focused. | 5
For our 2 keV electrons it is still possible to use an electrostatic lens. Cylindrically | 6
symmetrical pieces of conductor, like rings and tubes, can be set to an electrical | 7
potential and act as a lens for the electrons. By combining several of them, one can | 8
(theoretically) engineer an electro-optical system with any combination of desired focal | 9
lengths f1 and f2. The field of this system is simply governed by Laplace’s equation in | 10
cylindrical coordinates: | 11

0 =

1
r

∂φ
∂r +

∂

2φ
∂r2

+

∂

2φ
∂z2
(1.1) 12
If we take the axis of the beam to be the z-axis, the focal point position in the x-y-plane | 13
can be shifted using the two pairs of deflection plates, one for the x- and one for the | 14
y-direction. The deflection is achieved by applying a voltage between the two parallel | 15
plates. (see: fig. 1.3) By starting with an electron with kinetic energy e · U0 which is | 16
accelerated in x-direction by a constant force e · Ux/d over the extent of the plates L, 17
the deflection angle is approximately [Demtroeder3]: | 18

δ ≈ tan(δ) ≈

Ux · L
2U0 · d
(1.2) 19

For the measures of our CRT (L ≈ 10 cm, d ≈ 1 cm, U0 ≈ 2 kV and distance to 20
screen ≈ 20 cm) this amounts to a deflection coefficient of around 20 V cm−1
, which is | 21
quite consistent with the value given in the CRT’s manual. | können die Maße
| stimmen?

22

3

1 Cathodic Ray Tube Basics


Figure 1.3: Deflection of an electron beam in a constant electrical field

## 1.2 Implementation in the Heerlen D14-363GY

This section describes how the mechanisms described above are implemented in the CRT that was used in this project: the PDS/CRT Heerlen D14-363GY. Figure 1.4a shows an image of said CRT, fig. 1.4b shows a schematic depiction. The cathode is not visible, as it is fixed inside the Wehnelt cylinder (1), just a few millimeters from the exit of the wehnelt cylinder the electrons pass through the perforated anode (2) they gain their full final kinetic energy over this short distance. The electrons that go through the perforation and enter the electrostatic lens, have 2 keV and therefore move at a speed of approximately 0.08 c. The electrostatic lenses are realized using three conducting rings (3), that are set to the same potential but have varying radii: Each consecutive ring has a smaller radius than the previous one.

Between the electrostatic lens and the deflection plates, there is another aperture (4), which is internally connected to the anode and is thereby kept at the same potential. In our Setup, the deflection plates are not simply parallel but are shaped like funnels (5,7), between the two pairs of deflection plates, we have the final aperture (6), this ones potential can be regulated separately (usually it’s on the same potential as the anode)

It is connected to the aquadag coating inside the glass envelope and prevents charge up and image distortion. Finally the beam hits the phosphorous-coated screen which fluoresces on electron impact.

4

1 Cathodic Ray Tube Basics

Image of CRT

Missing
figure
(a) Image picture of the Heerlen D14-363GY

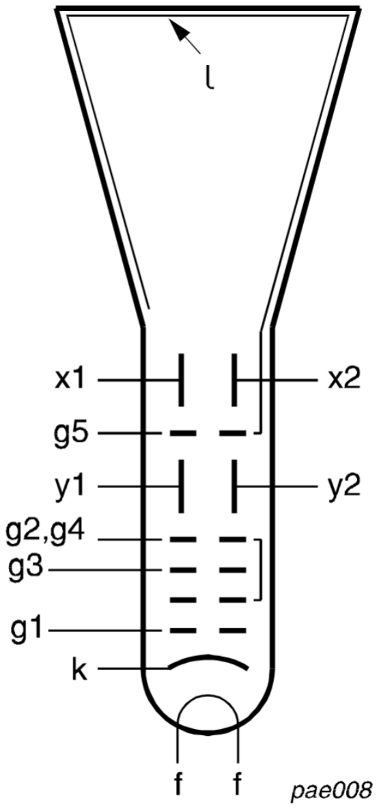
[picture p26: figure]

(b) | Schematic | of | the | CRT | from
[D14363GY123-manual]

Figure 1.4

5

1 Cathodic Ray Tube Basics

### 1.2.1 The Cathode

As already mentioned, we are using a hot cathode, where electrons are exited thermally until some of them acquire enough energy to leave the material. Compared to cold cathodes which work by field emission, this leads to a broader energy distribution. In fields like electron microscopy, where a high resolution is the goal, this in undesirable as it leads to some degree of chromatic aberration in the electron optics; for our purposes, this should not be a problem. On the other hand, hot cathodes normally allow for higher current densities, which is very important to us. The electron current from this kind of emission is described by [Whitaker]:

I = A · T

2
- e

−b/T
(1.3)

Where b is proportional to the work function of the material, T is temperature and A is a material-dependent constant. It is clear from this formula, that a low work function and a high melting point are important characteristics for a good cathode material.

The cathode from one of our Heerlen D14-363GY-tubes has been removed and examined with EDX (Energy-dispersive X-ray Spectroscopy). Nickel, barium, and strontium have been found, which suggests that it is a metal oxide cathode with barium-, strontium-, and possibly aluminum-oxide. This type of cathode is very common in low power electron tubes.

The “Power Vacuum Tubes Handbook” [Whitaker] describes a typical oxide cathode as a coating of barium and strontium oxides on a structure made from nickel alloys. Nickel is chosen for its strength and toughness, which it retains even at high tempera-tures. These cathodes are normally made by coating a case structure with a mixture of barium and strontium carbonates (typically 60 % Ba and 40 % Sr), suspended in a binder material and then baking the structure, causing the carbonates to be reduced to oxides.

These metal oxide cathodes normally operate at 700 ◦C to 820 ◦
C and are capable of
average emission densities of 100 mA cm−2

to 500 mA cm−2
. Still higher peak emissions are possible for shorter periods of time; as already mentioned, one of the advantages of this type of cathode is its high emission current capability compared to cathodes made from other materials. Downsides to this cathode type are its greater susceptibility to so-called oxygen poisoning and to ion bombardment. The literature therefore recommends to avoid prolonged exposure to oxygen. Oxygen poisoning is the process in which oxygen adsorbs onto the cathode and increases its work function, effectively reducing the ability to emit electrons. Also the material from the oxide cathode will

6

1 Cathodic Ray Tube Basics

evaporate during the tube’s lifetime and will travel to other parts of the tube, adsorbing to electron optics parts and turning them into additional emitters. The literature (also from [Whitaker]) therefore also advises against exceeding the design value for the heater voltage, as this reduces the lifetime of the cathode significantly. (However during the course of our project, we did drive the cathode with higher heater voltages on various occasions in order to increase the available beam current.)

### 1.2.2 Cathode Layout

Figure 1.5 shows how metal oxide cathodes for CRTs typically look; the depiction agrees very well with the layout of our cathode. On the image we see the cathode cylinder, which corresponds to the nickel support structure mentioned above. It is shaped into a cup, i.e. the cylinder is hollow and open on one side, where the heater filament (shaped into a heater coil) is inserted. The oxide disk, from where the electrons are emitted, 12 is baked onto the top of the cathode cylinder. The cathode cylinder is mounted on an isolating support structure and inserted into the Wehnelt cylinder, which is called “grid cup” in the drawing.

7

1 Cathodic Ray Tube Basics


Figure 1.5: Schematic of the layout of a typical CRT-cathode from [deVere69]

8

Todo list | 1
o | set date to English | | A | 2
o | können die Maße stimmen? | | 3 | 3
Figure: Image of CRT | | 5 125

9
