Preimtime/Project_CRT/Figures/Thesis-figure4.pdf

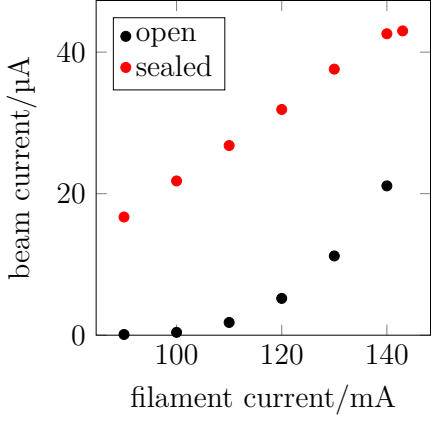
[picture p27: figure]
filament current/mA; beam current/µA; open sealed
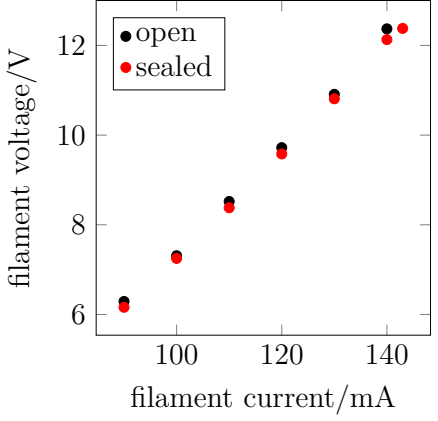
[picture p28: figure]
filament current/mA; filament voltage/V; open sealed
