Preimtime/Project_CRT/Figures/Thesis-figure6.pdf

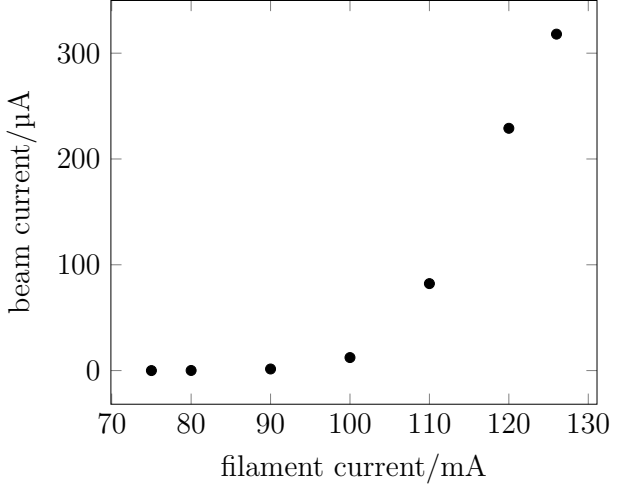
[picture p29: figure]
filament current/mA; beam current/
