Preimtime/Project_CRT/figure_work_bench.tex

\documentclass[tikz]{standalone}

\input{./Preamble/userColors.tex}	% define all colors used

% ********************************* Colors ************************************
%BEGIN_FOLD
\usepackage{xcolor}
%END_FOLD

% ********************************** TikZ *************************************
%BEGIN_FOLD
\usepackage{tikz}
%\include{./Class_Packages_and_Styles/tikzlibraryoptics}
\usepackage[siunitx]{circuitikz}	% Loading circuitikz with siunitx option
\usetikzlibrary{positioning, arrows, calc, 3d, decorations.pathreplacing ,decorations.markings, spy, fit, shapes, external} % fadings, shapes
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
%\usepackage{letltxmacro}
%\LetLtxMacro{\oldmissingfigure}{\missingfigure}
%\renewcommand{\missingfigure}[2][]{\tikzexternaldisable\oldmissingfigure[{#1}]{#2}\tikzexternalenable}
%\LetLtxMacro{\oldtodo}{\todo}
%\renewcommand{\todo}[2][]{\tikzexternaldisable\oldtodo[#1]{#2}\tikzexternalenable}

%---global plots settings
\pgfplotsset{legend style={overlay}, 			% set legends etc. as overlay to horizontaly align accoording to the axes
	ylabel style={overlay},
	yticklabel style={overlay}}
\newcommand{\marksSize}{3.5pt}					% size for marks in plots
\pgfplotsset{									% set san serif font for labels, axes, etc.
	tick label style = {font=\sansmath\sffamily},
	every axis label = {font=\sansmath\sffamily},
	legend style = {font=\sansmath\sffamily},
	label style = {font=\sansmath\sffamily}
}

%---zoom area variables for plot zooms with secound axis environment
\newcommand{\xStartZoom}{0.0}
\newcommand{\xEndZoom}{0.0}
\newcommand{\yStartZoom}{0.0}
\newcommand{\yEndZoom}{0.0}
\newcommand{\xStartZoomTwo}{0.0}
\newcommand{\xEndZoomTwo}{0.0}
\newcommand{\yStartZoomTwo}{0.0}
\newcommand{\yEndZoomTwo}{0.0}

%---pgf styles
\pgfplotsset{
	CoilCurrent/.style={line width=1.0pt, thick, y filter/.expression={y==0 ? nan : y},
		filter discard warning=false}
}
\pgfplotsset{
	x axis color/.style={
		xticklabel style=#1,
		xlabel style=#1,
		x axis line style=#1,
		xtick style=#1
	}
}
\pgfplotsset{
	y axis color/.style={
		yticklabel style=#1,
		ylabel style=#1,
		y axis line style=#1,
		ytick style=#1
	}
}

%---add custom plot marks
\pgfdeclareplotmark{xo}{%
	\pgfpathcircle{\pgfpointorigin}{\pgfplotmarksize}%
	\pgfpathmoveto{\pgfqpoint{-1.2\pgfplotmarksize}{-1.2\pgfplotmarksize}}%
	\pgfpathlineto{\pgfqpoint{1.2\pgfplotmarksize}{1.2\pgfplotmarksize}}%
	\pgfpathmoveto{\pgfqpoint{-1.2\pgfplotmarksize}{1.2\pgfplotmarksize}}%
	\pgfpathlineto{\pgfqpoint{1.2\pgfplotmarksize}{-1.2\pgfplotmarksize}}%
	\pgfusepathqstroke%
}
\pgfdeclareplotmark{Y}{%
	\pgfpathmoveto{\pgfpointorigin}%
	\pgfpathlineto{\pgfqpoint{0.0\pgfplotmarksize}{-1.0\pgfplotmarksize}}%
	\pgfpathmoveto{\pgfpointorigin}%
	\pgfpathlineto{\pgfqpoint{-1.0\pgfplotmarksize}{1.0\pgfplotmarksize}}%
	\pgfpathmoveto{\pgfpointorigin}%
	\pgfpathlineto{\pgfqpoint{1.0\pgfplotmarksize}{1.0\pgfplotmarksize}}%
	\pgfusepathqstroke
}

%---discontinuity
\pgfdeclaredecoration{discontinuity}{start}{
	\state{start}[width=0.5\pgfdecoratedinputsegmentremainingdistance-0.5\pgfdecorationsegmentlength,next state=first wave]{}
	\state{first wave}[width=\pgfdecorationsegmentlength, next state=second wave]{
		\pgfpathlineto{\pgfpointorigin}
		\pgfpathmoveto{\pgfqpoint{0pt}{\pgfdecorationsegmentamplitude}}
		\pgfpathcurveto
		{\pgfpoint{-0.25*\pgfmetadecorationsegmentlength}{0.75\pgfdecorationsegmentamplitude}}
		{\pgfpoint{-0.25*\pgfmetadecorationsegmentlength}{0.25\pgfdecorationsegmentamplitude}}
		{\pgfpoint{0pt}{0pt}}
		\pgfpathcurveto
		{\pgfpoint{0.25*\pgfmetadecorationsegmentlength}{-0.25\pgfdecorationsegmentamplitude}}
		{\pgfpoint{0.25*\pgfmetadecorationsegmentlength}{-0.75\pgfdecorationsegmentamplitude}}
		{\pgfpoint{0pt}{-\pgfdecorationsegmentamplitude}}
	}
	\state{second wave}[width=0pt, next state=do nothing]{
		\pgfpathmoveto{\pgfqpoint{0pt}{\pgfdecorationsegmentamplitude}}
		\pgfpathcurveto
		{\pgfpoint{-0.25*\pgfmetadecorationsegmentlength}{0.75\pgfdecorationsegmentamplitude}}
		{\pgfpoint{-0.25*\pgfmetadecorationsegmentlength}{0.25\pgfdecorationsegmentamplitude}}
		{\pgfpoint{0pt}{0pt}}
		\pgfpathcurveto
		{\pgfpoint{0.25*\pgfmetadecorationsegmentlength}{-0.25\pgfdecorationsegmentamplitude}}
		{\pgfpoint{0.25*\pgfmetadecorationsegmentlength}{-0.75\pgfdecorationsegmentamplitude}}
		{\pgfpoint{0pt}{-\pgfdecorationsegmentamplitude}}
		\pgfpathmoveto{\pgfpointorigin}
	}
	\state{do nothing}[width=\pgfdecorationsegmentlength,next state=do nothing]{
		\pgfpathlineto{\pgfpointdecoratedinputsegmentlast}
	}
	\state{final}{
		\pgfpathlineto{\pgfpointdecoratedpathlast}
	}
}
%END_FOLD

\begin{document}
	test
\begin{figure}[htb]
	\centering
	\begin{tikzpicture}[scale=0.7]
		\input{./Chapters/Experiment_Setup/fig_cryostat_overview.tex}
	\end{tikzpicture}
	\caption[test]{Testing a figure}
	\label{fig:test}
\end{figure}
\end{document}
