Preimtime/Project_CRT/Preamble/userColors.tex

% !TeX encoding = UTF-8
% !TeX spellcheck = en_US
% !TeX root = ../Thesis.tex
% HTML color codes taken from https://material.io/design/color/#color-color-palette
%---frequently used colors
\definecolor{TUblue}{RGB}{0, 102, 153}
\definecolor{rubidiumColor}{HTML}{D50000}

%---general colors
\definecolor{Black}{gray}{0.0}
\definecolor{Lightgray}{gray}{.50}
\definecolor{MatlabBlue}{rgb}{0.0,0.447,0.741}
\definecolor{MatlabMagenta}{rgb}{1.0,0.0,1.0}
\definecolor{LaserRed}{RGB}{255,131,127}
\definecolor{Gblue}{HTML}{1565C0}
\definecolor{GLblue}{HTML}{42A5F5}
\definecolor{Ggreen}{HTML}{8BC34A}
\definecolor{Gorange}{HTML}{FF9800}
\definecolor{Gpurple}{HTML}{7B1FA2}
\definecolor{Gmagenta}{HTML}{AD1457}
\definecolor{Gred}{HTML}{E53935}
\definecolor{HelpLineColor}{HTML}{757575}

%---spectrum
\definecolor{plotColorSpectrum1}{HTML}{673AB7}
\definecolor{plotColorSpectrum2}{HTML}{0D47A1}
\definecolor{plotColorSpectrum3}{HTML}{4FC3F7}
\definecolor{plotColorSpectrum4}{HTML}{43A047}
\definecolor{plotColorSpectrum5}{HTML}{64DD17}
\definecolor{plotColorSpectrum6}{HTML}{FFD600}
\definecolor{plotColorSpectrum7}{HTML}{FF9800}
\definecolor{plotColorSpectrum8}{HTML}{D50000}
\definecolor{plotColorSpectrum9}{HTML}{6D4C41}

%---Laser types
\definecolor{PdopedColor}{HTML}{EF9A9A}
\definecolor{NdopedColor}{HTML}{90CAF9}
\definecolor{ActiveZoneColor}{HTML}{26A69A}
\definecolor{GratingColor}{HTML}{616161}
\definecolor{PiezoColor}{HTML}{7B1FA2}
\definecolor{DiffractionGratingColor}{HTML}{81D4FA}
\definecolor{DiffractionGratingHandleColor}{HTML}{BDBDBD}

%---setup plots and sketeches
\definecolor{CryoHeadColor}{HTML}{B3E5FC}
\definecolor{HighPresssureLinesColor}{HTML}{81C784}
\definecolor{BellowColor}{HTML}{9E9E9E}
\definecolor{Cold50KColor}{HTML}{64B5F6}
\definecolor{Cold4KColor}{HTML}{5C6BC0}
\definecolor{ScienceChamberColor}{HTML}{FF9800}
\definecolor{TurboPumpColor}{HTML}{BA68C8}
\definecolor{RougheningPumpColor}{HTML}{F48FB1}
\definecolor{PipeColor}{HTML}{BCAAA4}
\definecolor{ChipMountColor}{HTML}{B2DFDB}
\definecolor{DirectImgColor}{HTML}{CDDC39}
\definecolor{ReflectImgColor}{HTML}{FB8C00}
\definecolor{ChipWireColor}{HTML}{D84315}
\definecolor{ChipFieldColor}{HTML}{81D4FA}
\definecolor{sketchColorBiasField}{HTML}{4CAF50}
