Preimtime/Project_CRT/Chapters/Declaration/declaration.tex

% !TeX encoding = UTF-8
% !TeX spellcheck = en_US
% !TeX root = ../../Thesis.tex
\begin{declaration}
	
	This report is the result of a collaboration between Frank Takara Ebel and Alexander Preimesberger. As we have worked on the project together over more or less the same period of time, any separation into two projects was deemed artificial. We have therefore decided to present the results of our work together as a whole. Both authors contributed equally to the experimental work and the writing of the report.
	
	%Author and date will be inserted automatically
\end{declaration}
