Preimtime/Project_CRT/Chapters/Abstract/zusammenfassung.tex

% !TeX encoding = UTF-8
% !TeX spellcheck = de_DE
% !TeX root = ../../Thesis.tex
\begin{Zusammenfassung}
Kurz und bündig...
\end{Zusammenfassung}
