Preimtime/Project_CRT/Chapters/Appendix/appendix_A.tex

% !TeX encoding = UTF-8
% !TeX spellcheck = en_US
% !TeX root = ../../Thesis.tex
\chapter{Appendix}\label{chap:appendix}
\section{Appendix A}\label{sec:appendix_a}
\subsection{Source Code}\label{sec:source_code}
Here is some source code added with the lstlisting package. With \begin{verbatim}$£\vdots£$\end{verbatim} you can insert vertical dots to truncate code.
\begin{lstlisting}[basicstyle=\footnotesize, escapeinside={$£}{£$}]
/*++++++++++++++++++++++++++++++++++
+                   Awesome source code                    +
+                       TU Wien 2018                       +
+                      Thomas Weigner                      +
+                weigner.thomas@gmail.com                  +
+                         main.cpp                         +
+                         vers 3.4.1                       +
++++++++++++++++++++++++++++++++++*/

#include <header.h>
//---main program
int main(){
//---declare stuff and initialize things
$£\vdots£$
//------generating polynom for vertical transport
Poly polArray[5];           //Creating a polynom object array with the default constructor
double vMax = 2.0;          //maximal velocity
$£\vdots£$
\end{lstlisting}

\subsection{Matlab2Tikz}\label{sec:matlab2tikz}
Matlab to Tikz a is a very power full script to translate a Matlab figure into Tikz and Pgf code. After creating a file containing the code with this Matlab script one can do fine adjustments directly in the code. If you are not already using it you should go and check it out.
