Preimtime/Project_CRT/Chapters/Chapter2/chapter_2.tex

% !TeX encoding = UTF-8
% !TeX spellcheck = en_US
% !TeX root = ../../Thesis.tex
\chapter{Chapter 2}\label{chap:chapter_2}
Here some Pgf exemplary plots.

\begin{figure}[H]
	\centering	
	\begin{tikzpicture}[scale=0.6]
		\input{./Chapters/Chapter2/fig_zeeman_splitting}
	\end{tikzpicture}
	\caption[\person{Zeeman} splitting]{\person{Zeeman} splitting of the \Rb ground state $5^2\mathrm{S}_{1/2}$.}
	\label{fig:zeeman_splitting_breit_rabi}
\end{figure}

\begin{figure}[H]
	\centering
	\begin{tikzpicture}[scale=0.88]
		\input{./Chapters/Chapter2/fig_vertical_transport_dynamics_space}
	\end{tikzpicture}
	\caption[pgf plot with zoom]{pgf plot with zoom}
	\label{fig:vertical_transport_dynamics_a}
\end{figure}
