Preimtime/Project_CRT/Chapters/Dedication/dedication.tex

% !TeX encoding = UTF-8
% !TeX spellcheck = en_US
% !TeX root = ../../Thesis.tex
\begin{dedication}
\emph{“The Setesh guard’s nose drips.”}\\
\person{Teal'c}
\end{dedication}
