Preimtime/Project_CRT/Figures/Thesis-figure5.pdf

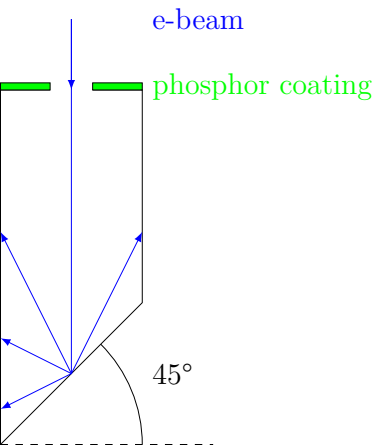
[picture p30: figure]
e-beam; phosphor coating
