Preimtime/Project_CRT/Preamble/Figures/TU_Logo.pdf

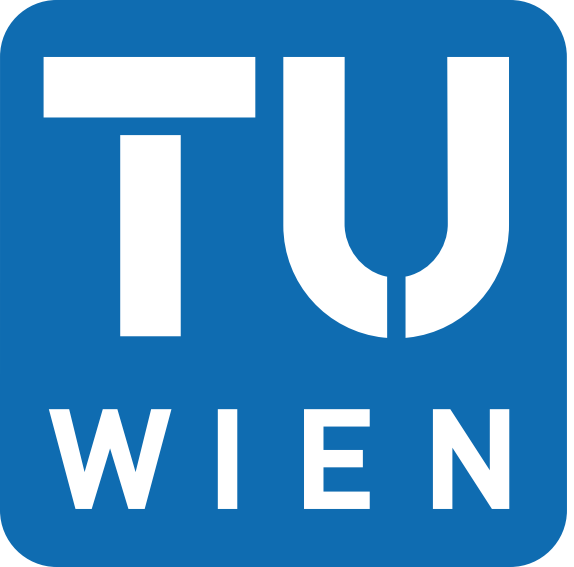
[picture p31: figure]
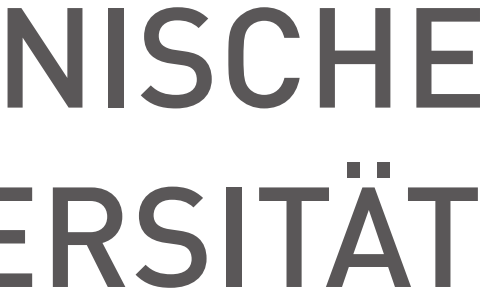
[picture p32: figure]
