Preimtime/Project_CRT/Chapters/CRT-Basics/DeflectionPlate.png

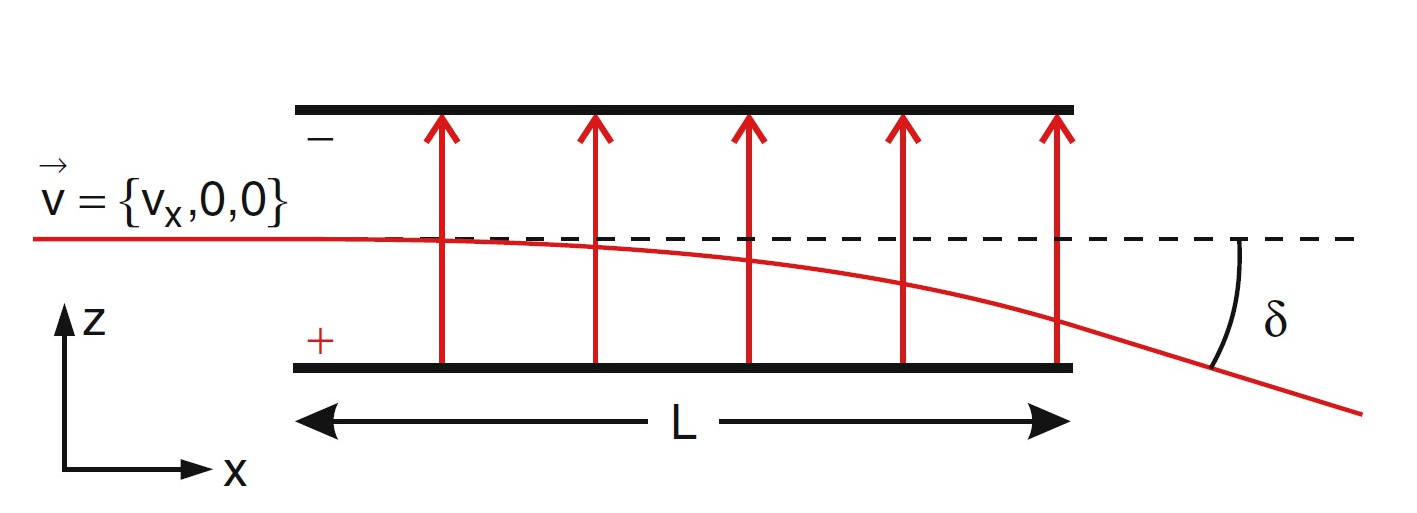
Chapters/CRT-Basics/DeflectionPlate.png
