Preimtime/Project_CRT/Chapters/CRT-Basics/electron_gun236.png

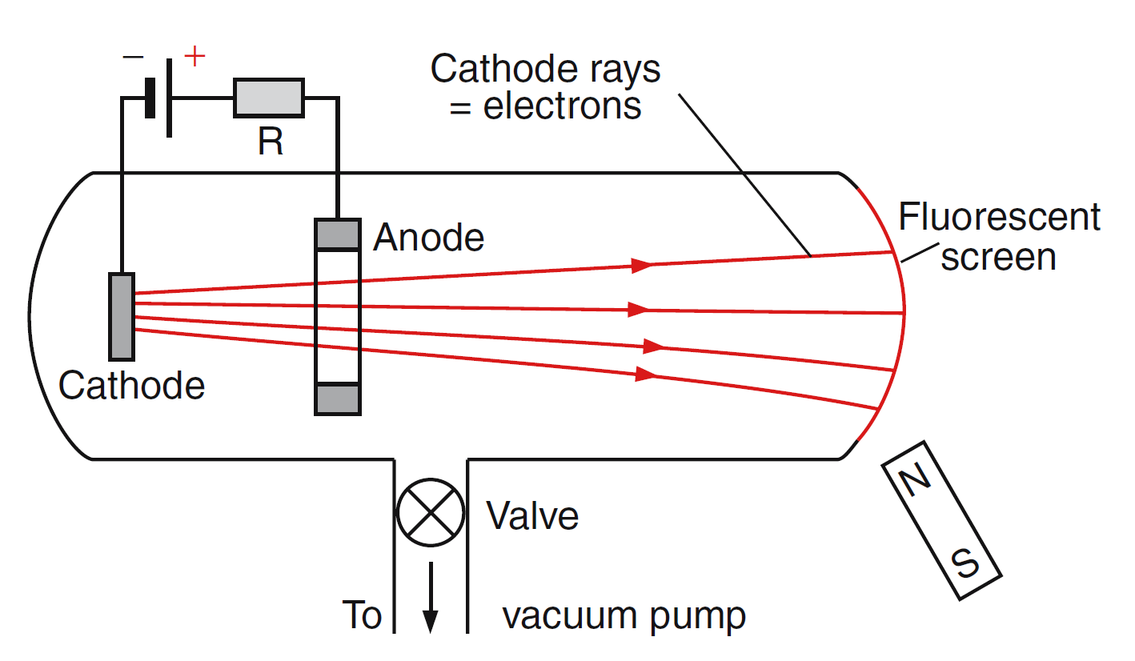
Chapters/CRT-Basics/electron_gun236.png
