Preimtime/Project_CRT/Chapters/CRT-Basics/HotCathodeColdCathode.png

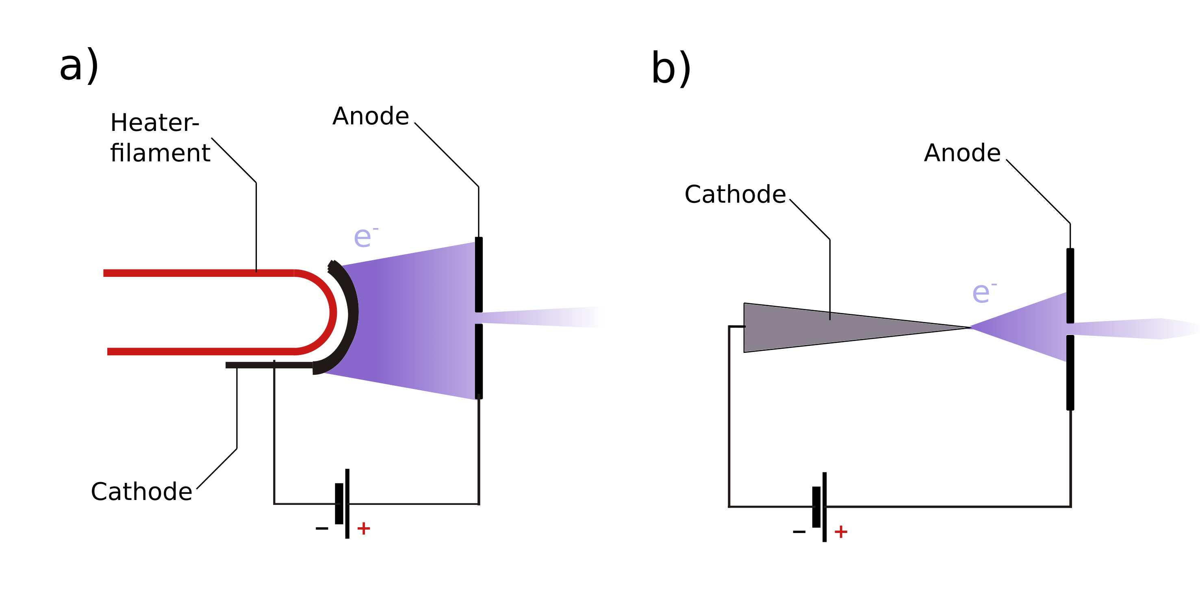
Chapters/CRT-Basics/HotCathodeColdCathode.png
