Preimtime/Project_CRT/Chapters/Deflection/biased2.png

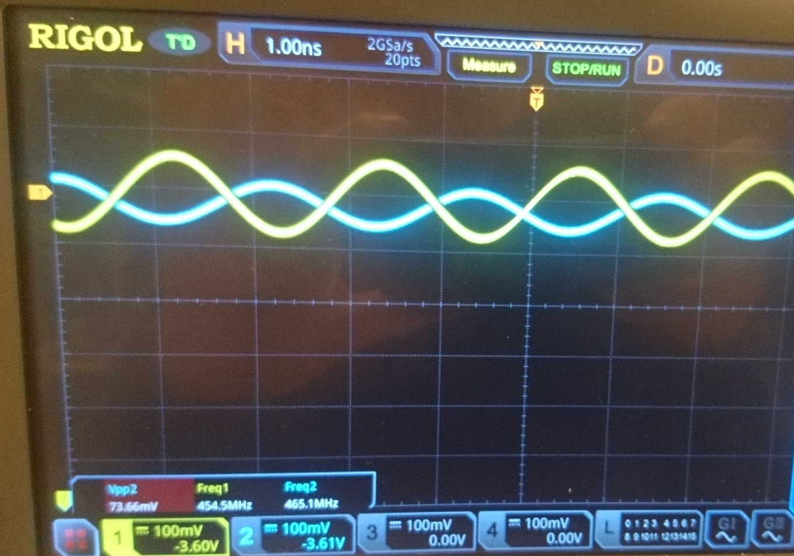
Chapters/Deflection/biased2.png
