Preimtime/Project_CRT/Chapters/Deflection/biased.jpeg

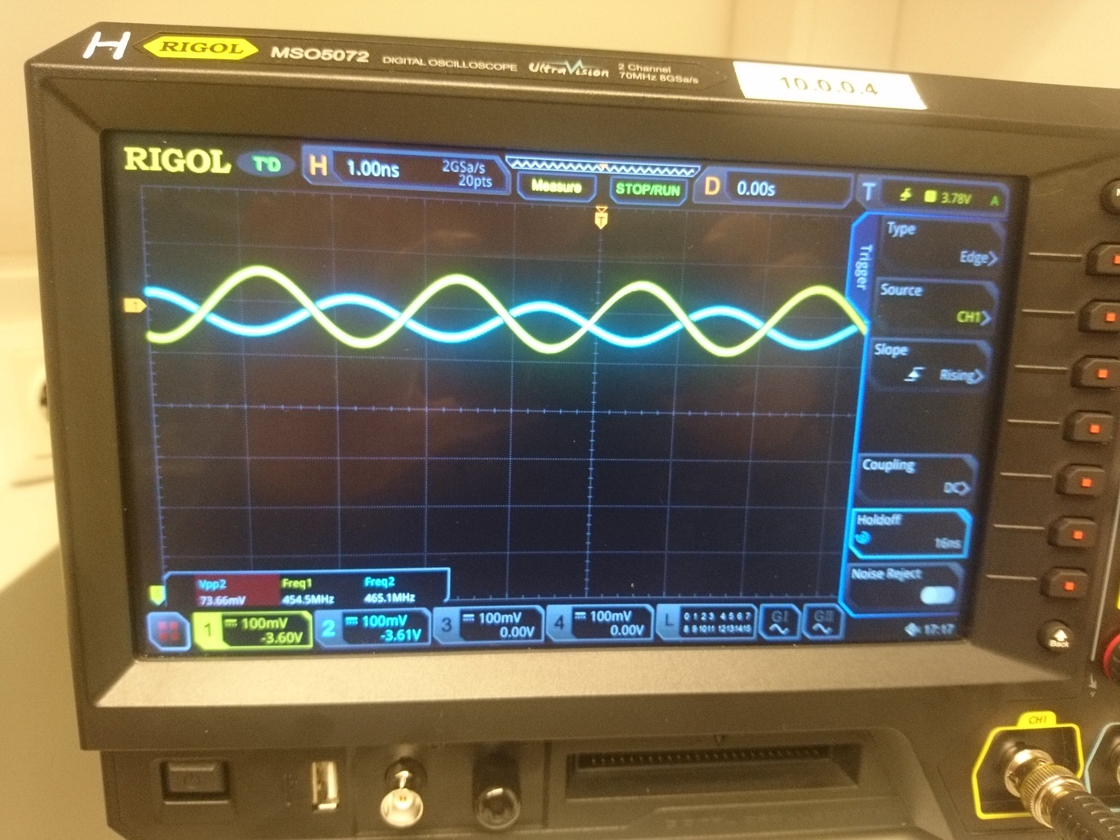
Chapters/Deflection/biased.jpeg
