Preimtime/Project_CRT/Chapters/Deflection/circuit_CTT.png

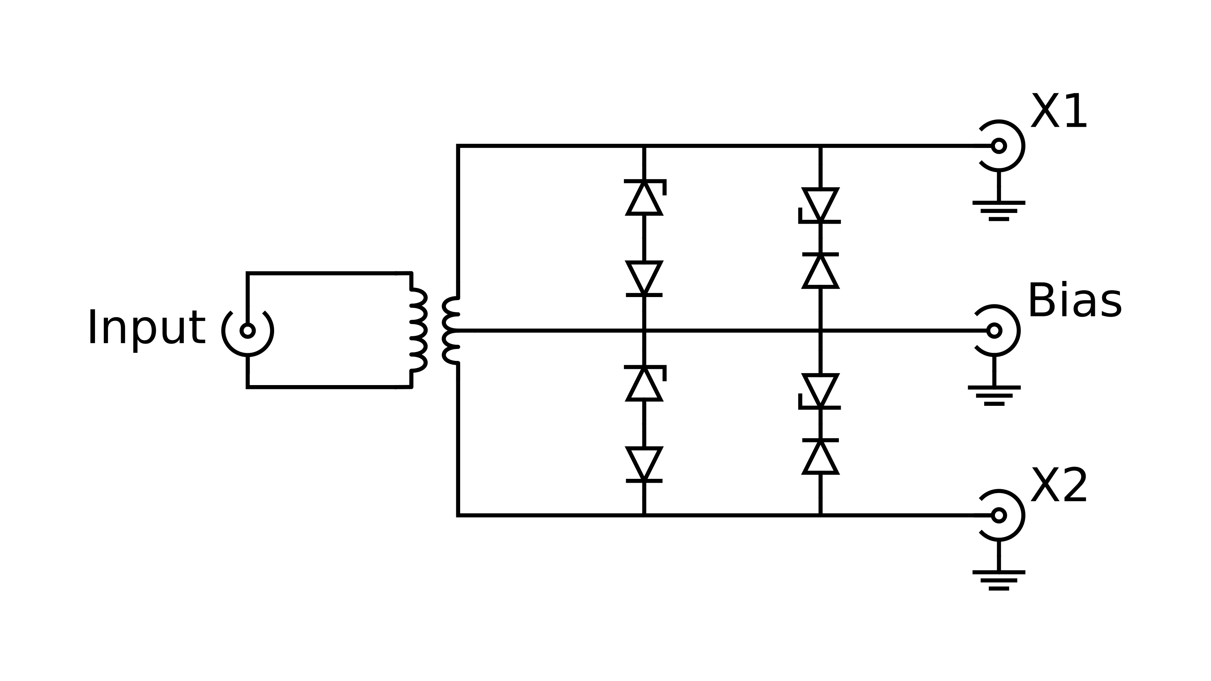
Chapters/Deflection/circuit_CTT.png
