Preimtime/Project_CRT/Chapters/Deflection/circuit_phase.png

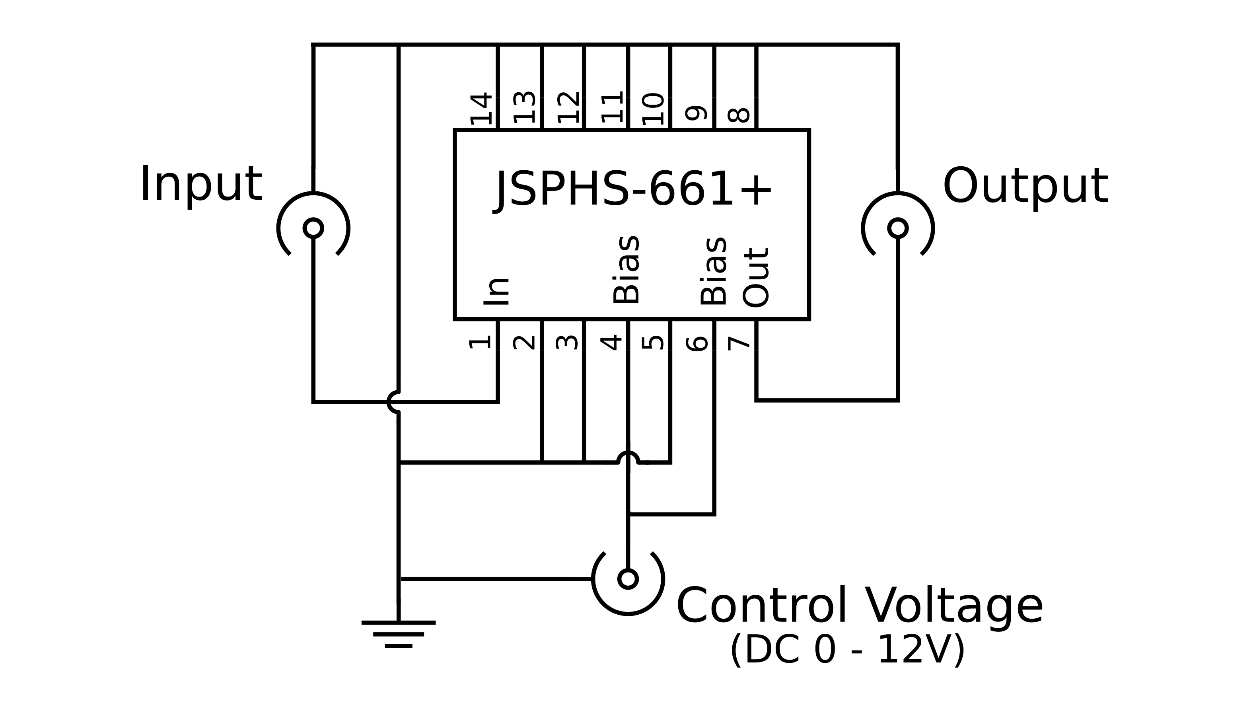
Chapters/Deflection/circuit_phase.png
