Preimtime/Project_CRT/Chapters/Deflection/deflec_circuit.png

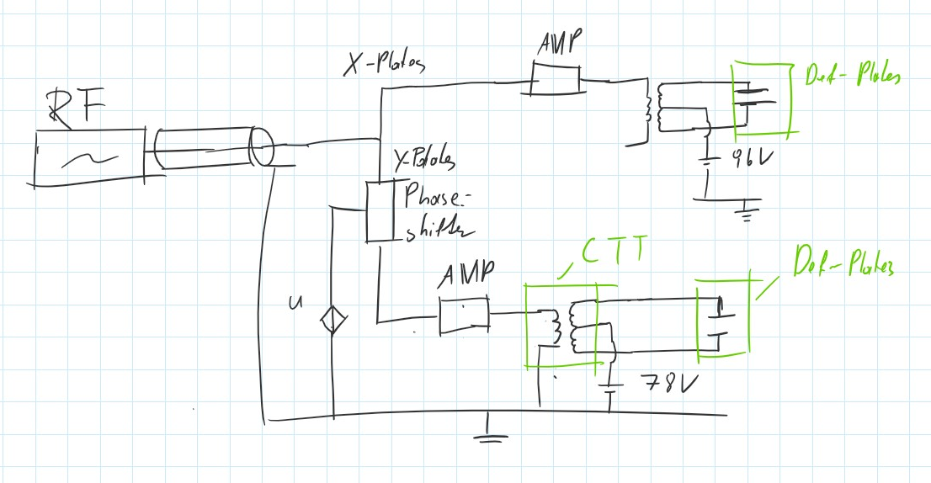
Chapters/Deflection/deflec_circuit.png
