Preimtime/Project_CRT/Chapters/Deflection/Lissajous.png

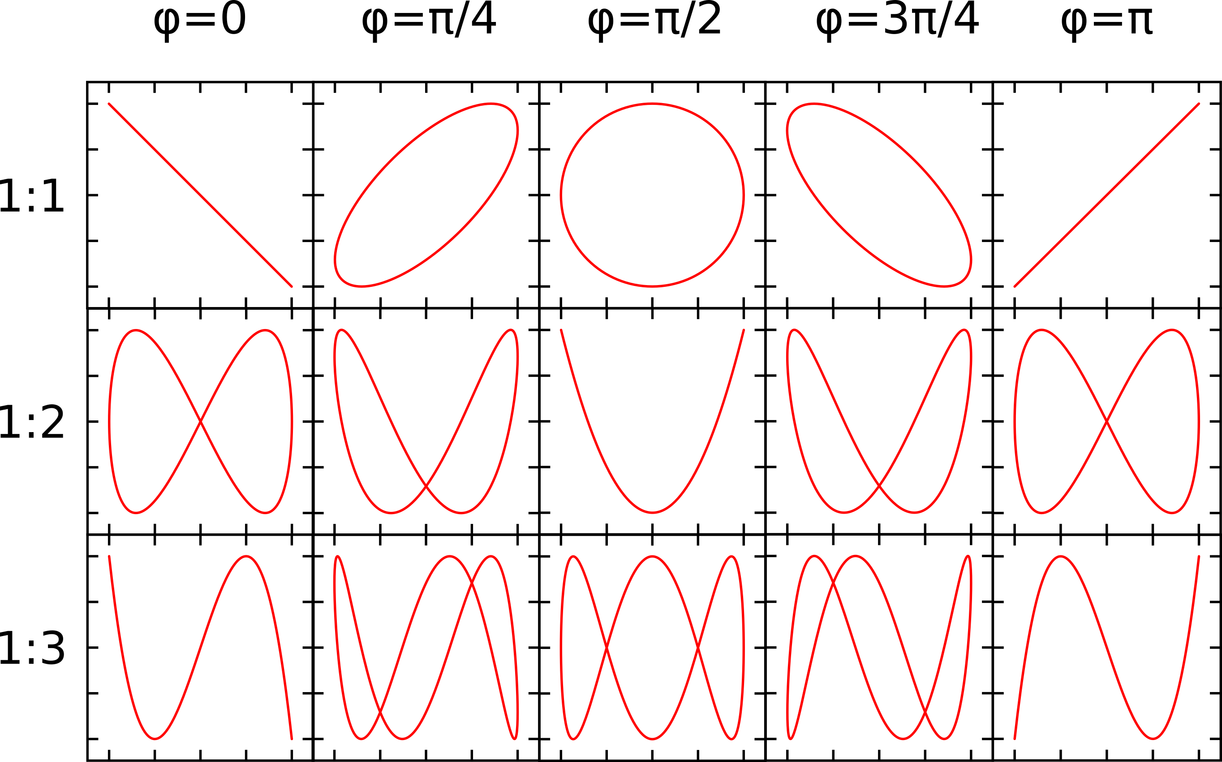
Chapters/Deflection/Lissajous.png
