Preimtime/Project_CRT/Chapters/Deflection/PCBs/PCB_CTT.png

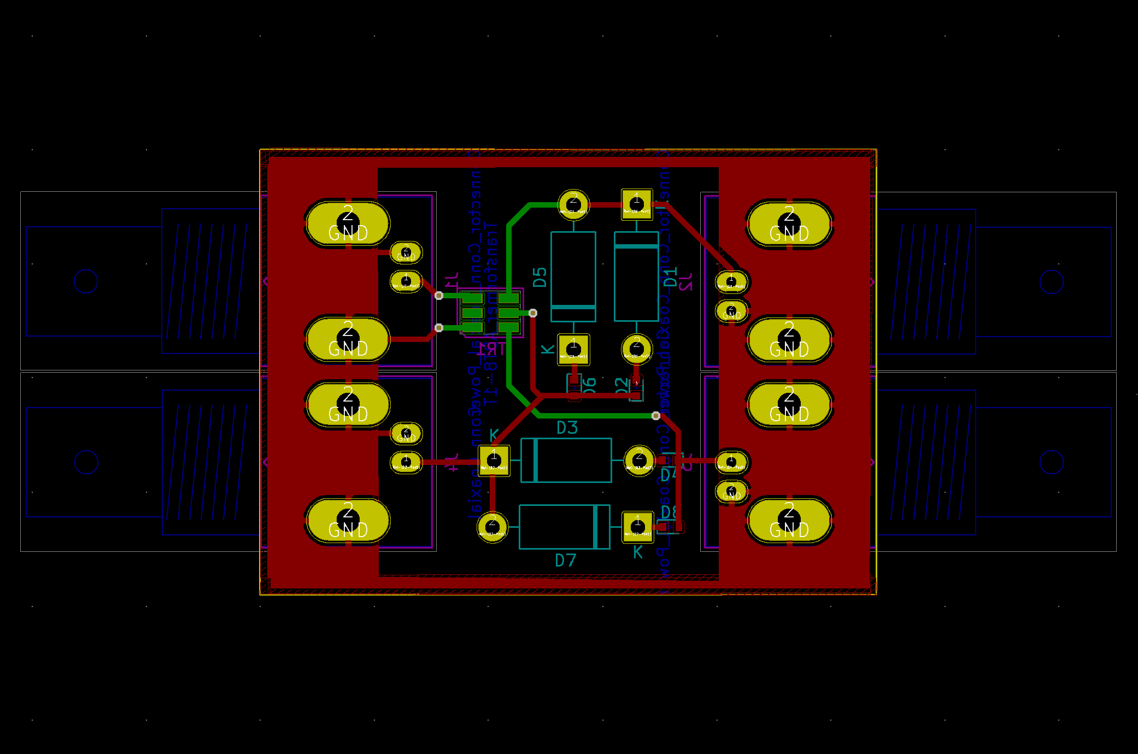
Chapters/Deflection/PCBs/PCB_CTT.png
