Preimtime/Project_CRT/Chapters/Deflection/PCBs/PCB_phase.png

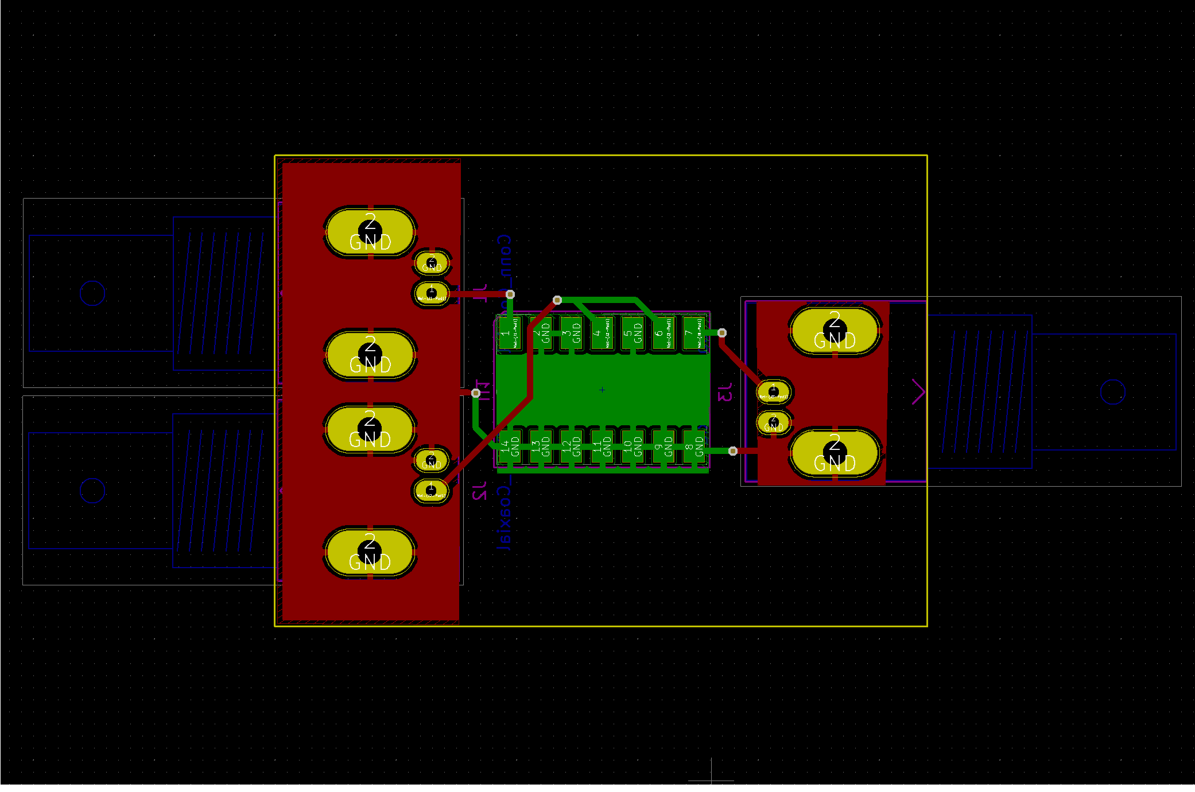
Chapters/Deflection/PCBs/PCB_phase.png
