Preimtime/Project_CRT/Chapters/Deflection/unbiased.jpeg

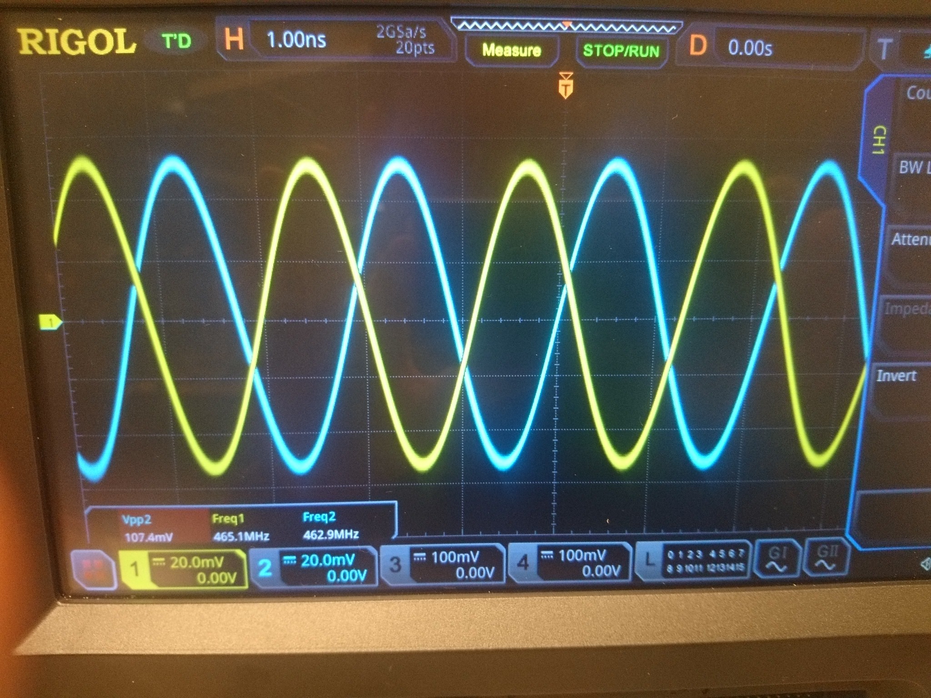
Chapters/Deflection/unbiased.jpeg
