Preimtime/Project_CRT/Preamble/nomenclature.tex

% !TeX encoding = UTF-8
% !TeX spellcheck = en_US
% !TeX root = ../Thesis.tex
%---acronyms
\nomenclature[A-Q]{QuIc}{Quantum Interconnect}
