Preimtime/Project_CRT/Chapters/e-beam-setup/fig_CRT_pin_voltage_supply.tex

% !TeX encoding = UTF-8
% !TeX spellcheck = en_US
% !TeX root = ../../Thesis.tex

%\draw [help lines] (0,0) grid (10,10);
		
\newcommand{\hvps}[2] % corordinates of bottom left corner, label
% draw a hvps
{		
	% draw HVPS
	\draw (0 + {#1}[0], 0 + {#1}[1]) rectangle (2.5 + {#1}[0], 2.5 + {#1}[1]); % box of size 2.5
	\node[above] at (1.25 + {#1}[0], 2.5 + {#1}[1]) {#2};	% label for box
	\draw (3 + {#1}[0], 1 + {#1}[1]) -- (1.5 + {#1}[0], 1 + {#1}[1]) to[vsource] (1.5 + {#1}[0], 2 + {#1}[1]) -- (3 + {#1}[0], 2 + {#1}[1]);  % voltage supply
	\draw (1.5 + {#1}[0], 0.5 + {#1}[1]) -- (3 + {#1}[0], 0.5 + {#1}[1]) node[ground] {}; % ground
}

\newcommand{\coaxial}[2] % coordinates of left inner wire, length of cable
% draw a coaxial cable with given length
{
	\draw (0 + {#1}[0], {#1}[1]) to[short, *-*] (#2 + {#1}[0], {#1}[1]); % middle line
	\draw (1 + {#1}[0], {#1}[1]) circle [radius=0.5]; % left circle
	\draw (#2 - 1 + {#1}[0], {#1}[1]) circle [radius=0.5]; % right circle
	\draw (1 + {#1}[0], 0.5 + {#1}[1]) -- (#2 - 1 + {#1}[0], 0.5 + {#1}[1]); % top line
	\draw (0 + {#1}[0], -0.5 + {#1}[1]) to[short, *-*] (#2 + {#1}[0], -0.5 + {#1}[1]); % bottom line
}

% HVPS 4
\hvps{(0, 0)}{HVPS 4}
\draw (3, 2) -- (3, 1.5);
\coaxial{(3, 1.5)}{5}
\draw (8, 1.5) -- (10, 1.5);
\node [right] at (10, 1.5) {i.c.};

% HVPS 3
\hvps{(0, 4)}{HVPS 3}
\draw (3, 6) -- (3, 5.5);
\coaxial{(3, 5.5)}{5}
\draw (8, 5.5) -- (10, 5.5);
\node [right] at (10, 5.5) {g3};

% HVPS 2
\hvps{(0, 8)}{HVPS 2}
\draw (3, 10) -- (3, 9.5);
\coaxial{(3, 9.5)}{5}
\draw (8, 9.5) -- (10, 9.5);
\node [right] at (10, 9.5) {f};
\draw (9, 9.5) to[sV, *-] (9, 8); % ac voltage source
\draw (9, 8) to[short, *-] (10, 8);
\node [right] at (10, 8) {f};
\draw (9, 8) -- (9, 7) -- (10, 7);
\node [right] at (10, 7) {k};

% HVPS 1
\hvps{(0, 12)}{HVPS 1}
\draw (3, 14) -- (3, 13.5);
\coaxial{(3, 13.5)}{5}
\draw (8, 13.5) -- (10, 13.5);
\node [right] at (10, 13.5) {g1};
