Preimtime/Project_CRT/Test Refs.tex

\documentclass{article}
\usepackage[utf8]{inputenc}
\usepackage[english]{babel}

\usepackage{biblatex}
\addbibresource{./References/references.bib}

\begin{document}

	\printbibliography
	
\end{document}
