Preimtime/Project_CRT/Chapters/beam-characterization/data_aluminum_foil_opened.csv

current_filament | voltage | current
140 | 12.37 | 21.1
130 | 10.91 | 11.2
120 | 9.72 | 5.2
110 | 8.52 | 1.8
100 | 7.31 | 0.4
90 | 6.29 | 0.1
