Preimtime/Project_CRT/Chapters/beam-characterization/data_aluminum_foil_sealed.csv

current_filament | voltage | current
143 | 12.38 | 43.0
140 | 12.13 | 42.6
130 | 10.81 | 37.6
120 | 9.58 | 31.9
110 | 8.38 | 26.8
100 | 7.25 | 21.8
90 | 6.16 | 16.7
