Preimtime/Project_CRT/Chapters/beam-characterization/data_Faraday_cup.csv

current_filament | current_beam
126 | 318
120 | 229
110 | 82.2
100 | 12.3
90 | 1.5
80 | 0.1
75 | 0
