Preimtime/Project_CRT/Chapters/vacuum-chamber/test_chamber_original.png

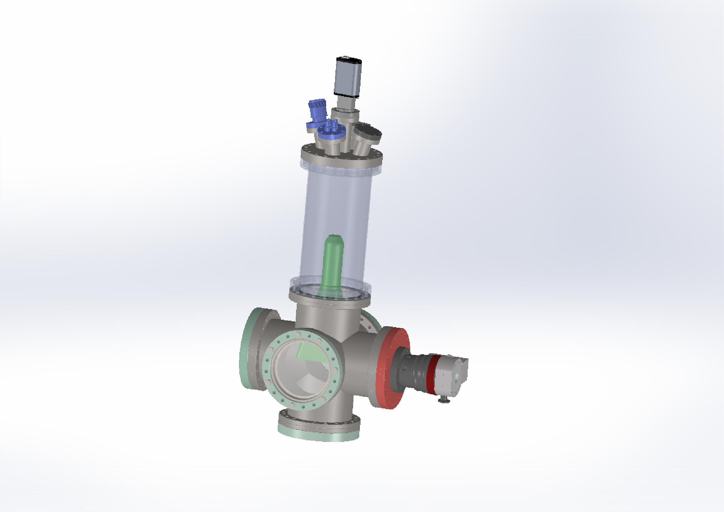
Chapters/vacuum-chamber/test_chamber_original.png
