Preimtime/Project_CRT/Figures/Thesis-figure1.pdf

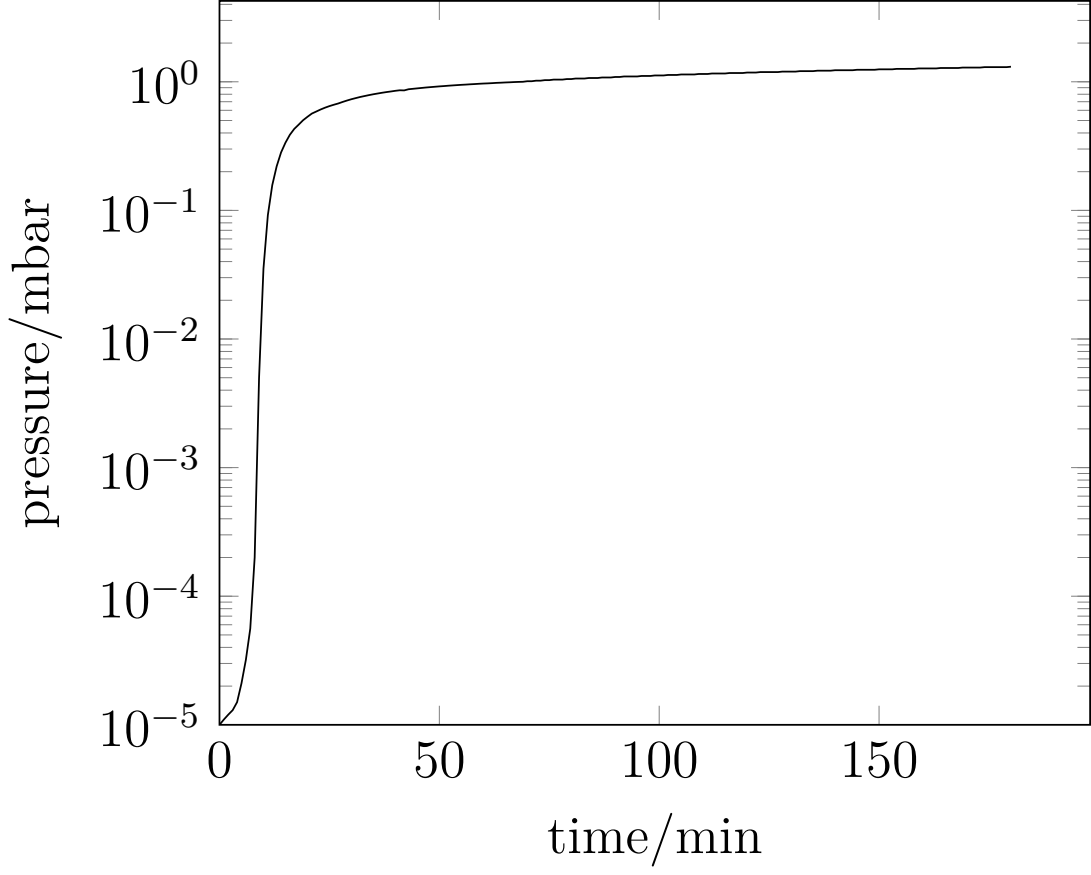
[picture p48: page 1]
time/min; pressure/mbar
