Preimtime/Project_CRT/Figures/Thesis-figure0.pdf

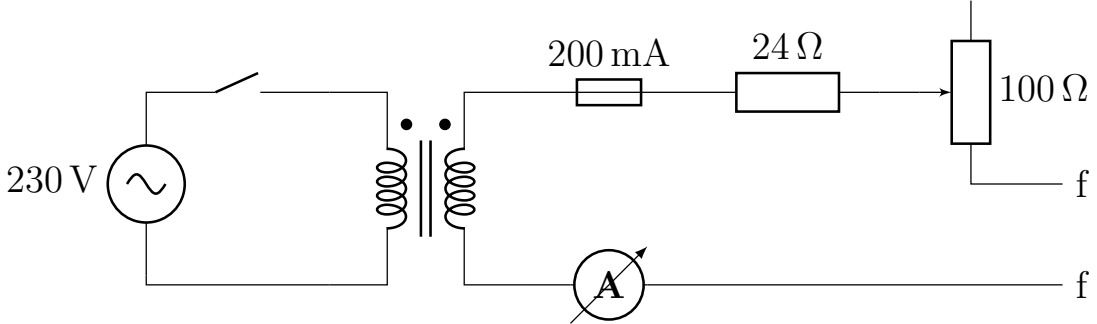
[picture p49: page 1]
