Preimtime/Project_CRT/Figures/Thesis-figure2.pdf

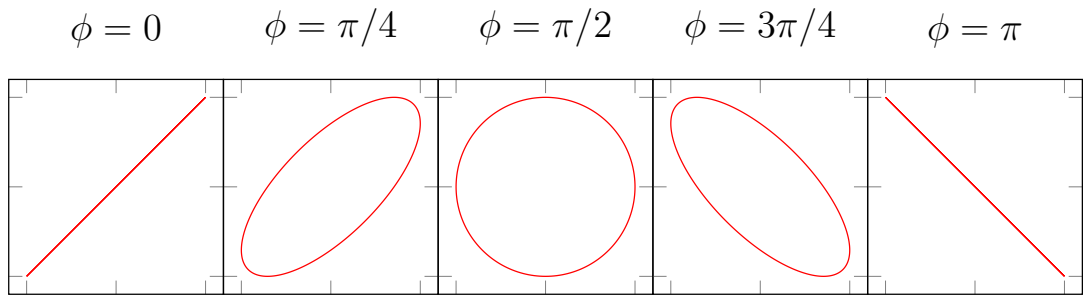
[picture p50: page 1]
