Preimtime/Project_CRT/Figures/Thesis-figure3.pdf

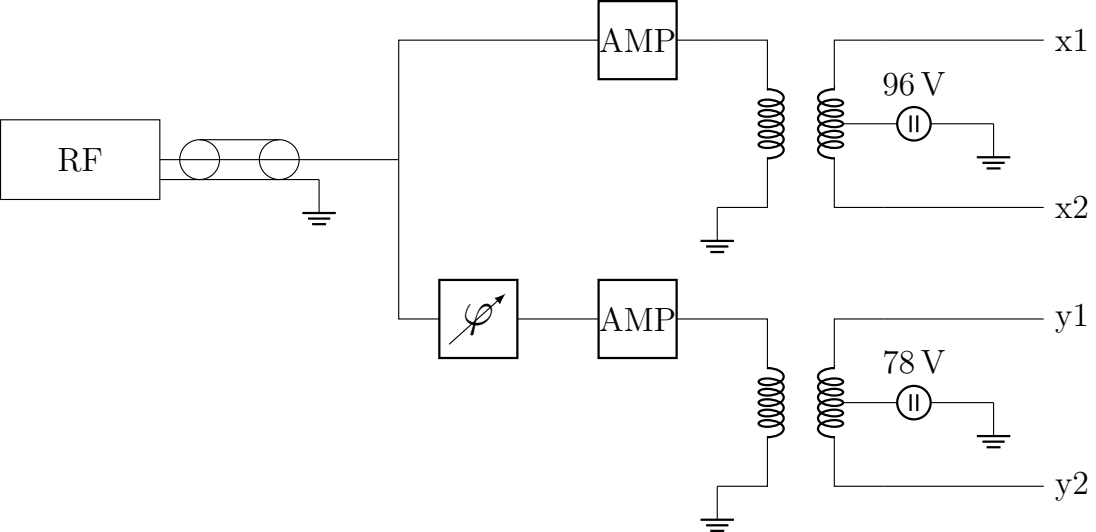
[picture p51: page 1]
AMP
