Preimtime/Project_CRT/Chapters/Deflection/CTT_print.pdf

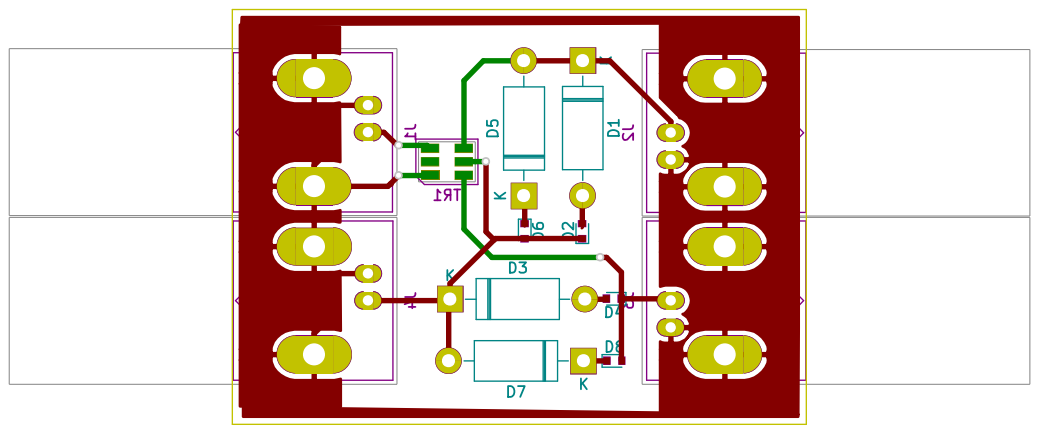
[picture p52: page 1]
