Preimtime/Project_CRT/Preamble/Figures/ATI-Logo_bl_auf_ws.pdf

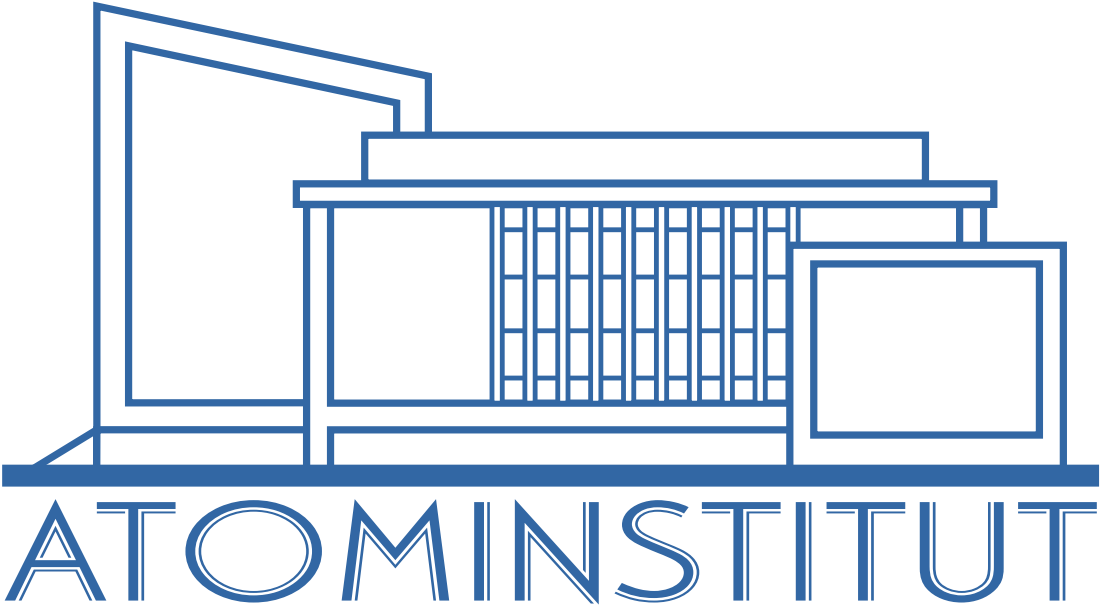
[picture p54: page 1]
