Preimtime/Project_CRT/Chapters/Deflection/PCB_phase2.pdf

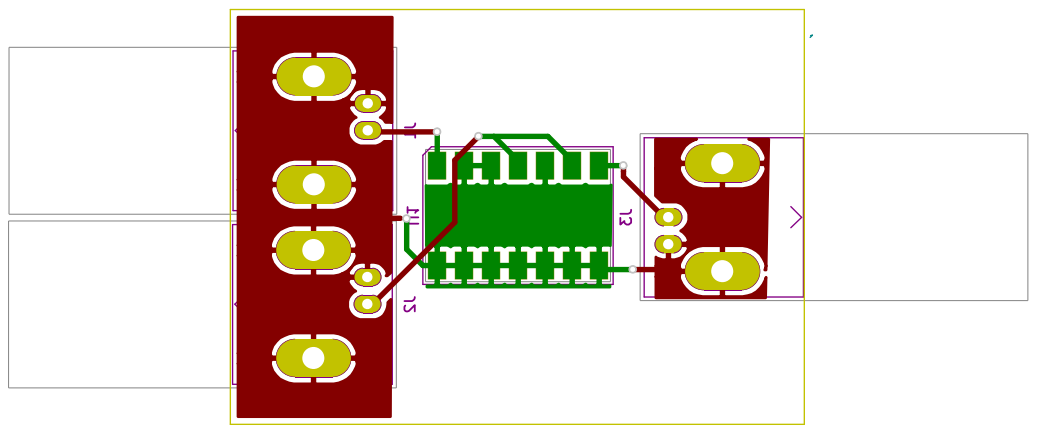
[picture p55: page 1]
