Preimtime/Project_CRT/Preamble/Figures/ATI-Logo_sw_auf_ws.pdf

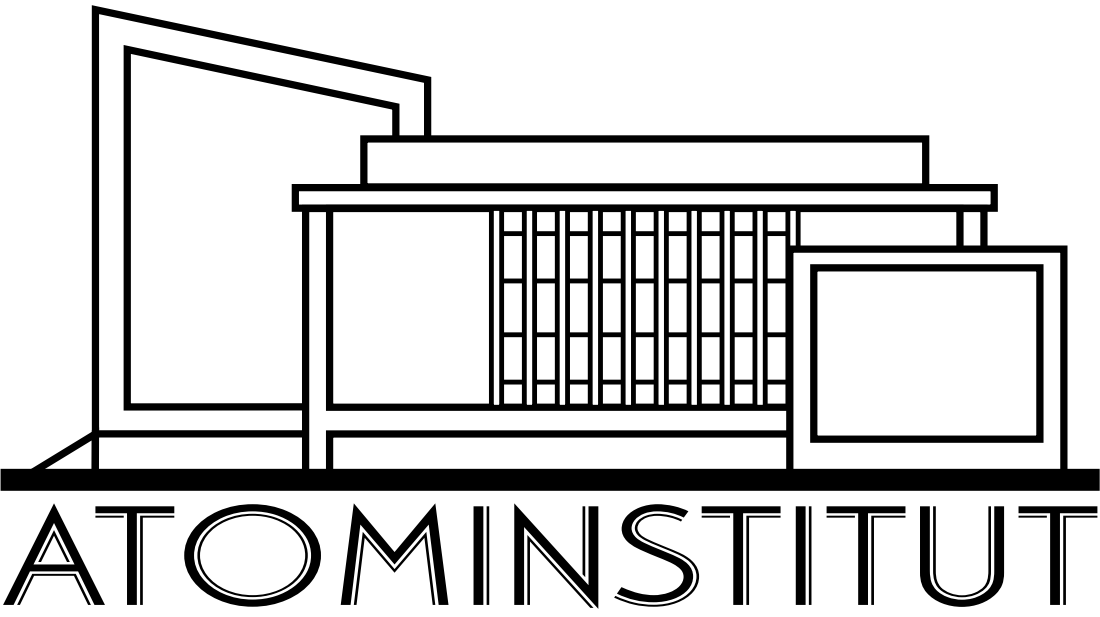
[picture p56: page 1]
