Preimtime/Project_CRT/(commit log)

2018-09-26 Initialize thesis template
    [data_breit_rabi.csv, data_vertical_transport_dynamics.csv]
2020-02-12 added nooldvoltagedirection to utilize german standard of voltage arrows
2020-03-27 table changed g3 voltage and current
2020-03-27 did schematics of CRT wiring
2020-03-31 First Iteration of "underlying Physics"
    Inserted a first verision of the underlying physics section
2020-04-05 Added Heater Section
2020-04-05 Update references.bib
    Inserted Data Sheets of heater parts
2020-04-08 include heater section in ebs.tex and save tikz image code in external file
2020-04-08 small corrections on heater section
2020-04-08 redraw circuit diagram so that f is in series to potentiometer
2020-04-16 finer description of steel wire
2020-04-16 add chapter about vacuum chamber
2020-04-18 add images of test chamber 1st iteration
2020-04-18 add data and plot of leak rate
    [leak_rate.csv]
2020-04-18 writing about first iteration of vacuum chamber
2020-04-21 Inserted Cathode Schematic
    from Chuck deVere's book
2020-04-22 rewrote 1st iteration on vacuum chamber
2020-04-23 Added Figure "VoltageAspects"
2020-04-23 A Ton of figures
    [Centretappedtrafo.kicad_pcb, Centretappedtrafo.sch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]
2020-04-25 Inserted Defelction Text
2020-04-26 add reached pressures
2020-05-04 move notes from vacuum-chamber to beam-characterization
2020-05-05 add plot and accompanied data
    [data_aluminum_foil_opened.csv, data_aluminum_foil_unopened.csv]
2020-05-06 section about Faraday cup
    [data_Faraday_cup.csv]
2020-05-07 rename unopened CRT to sealed CRT
    [data_aluminum_foil_sealed.csv]
2020-05-15 K 39 inserted
2020-05-15 untrack .dpth and track .md5
2021-01-03 correction ch vaccum chamber
2021-01-06 major correction ch vacuum chamber
2021-01-06 correction vacuum chamber talked on meeting
2021-01-08 add circuitikz of deflection circuit
2021-01-11 Update test-chamber grafik
2021-02-14 corrections ch vacuum chamber
2021-03-12 add heater schematics to presentation
